TKCAJS/T89_2xESP32_front-rear_with_CanBUS/T89_Gearbox_Flowcharts.docx

Shift Up button pressed — ignition cut upshift

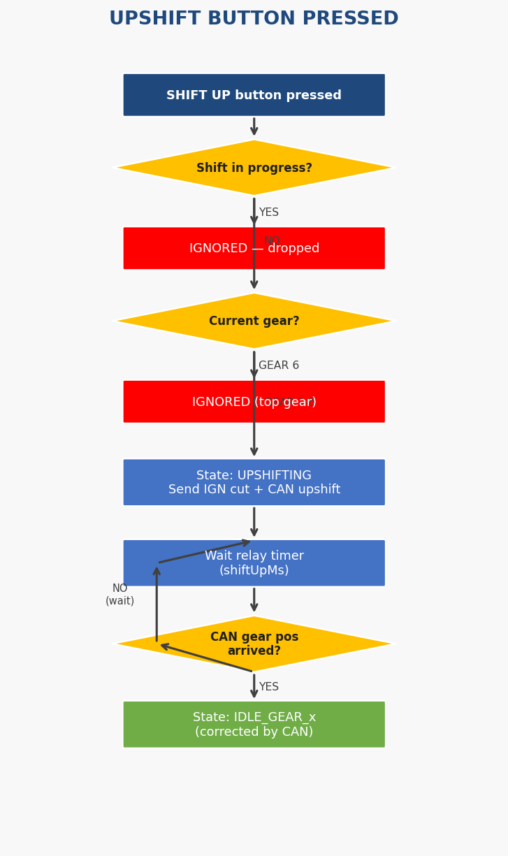
[picture p1: figure]

Shift Down button pressed — clutch servo downshift

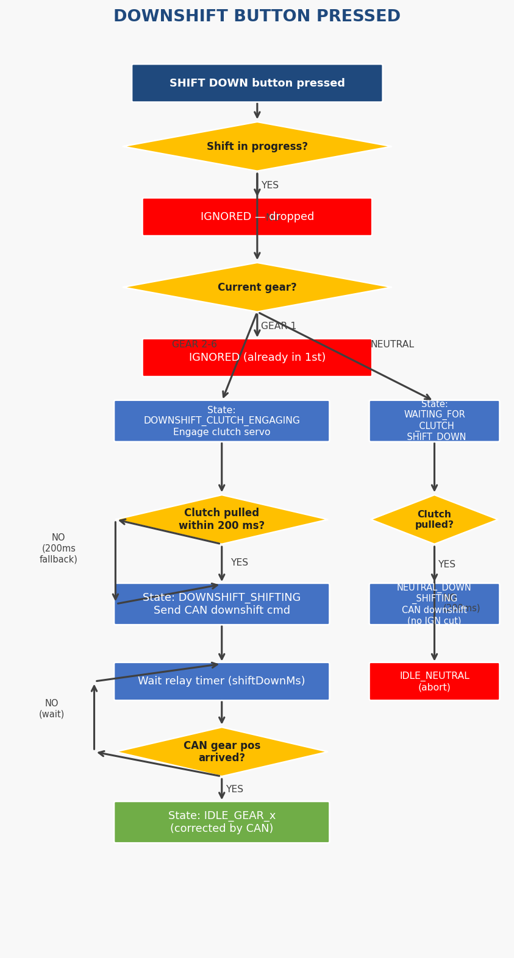
[picture p2: figure]

Neutral button pressed — single button, direction by gear

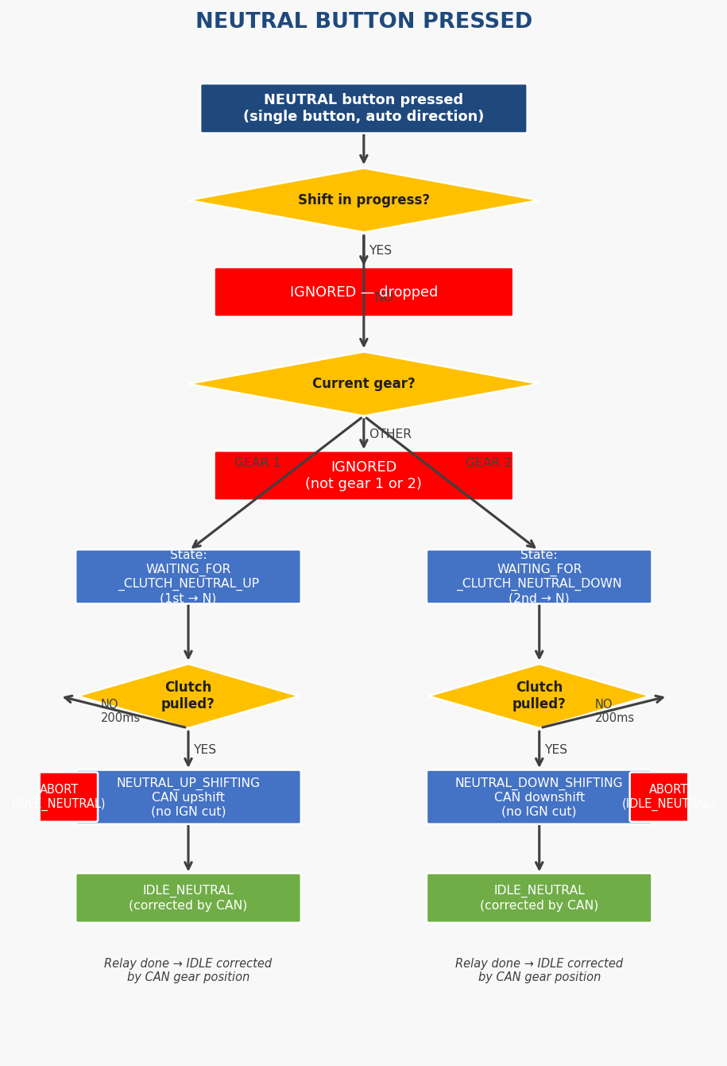
[picture p3: figure]

Manual mode — toggle and direct shift commands

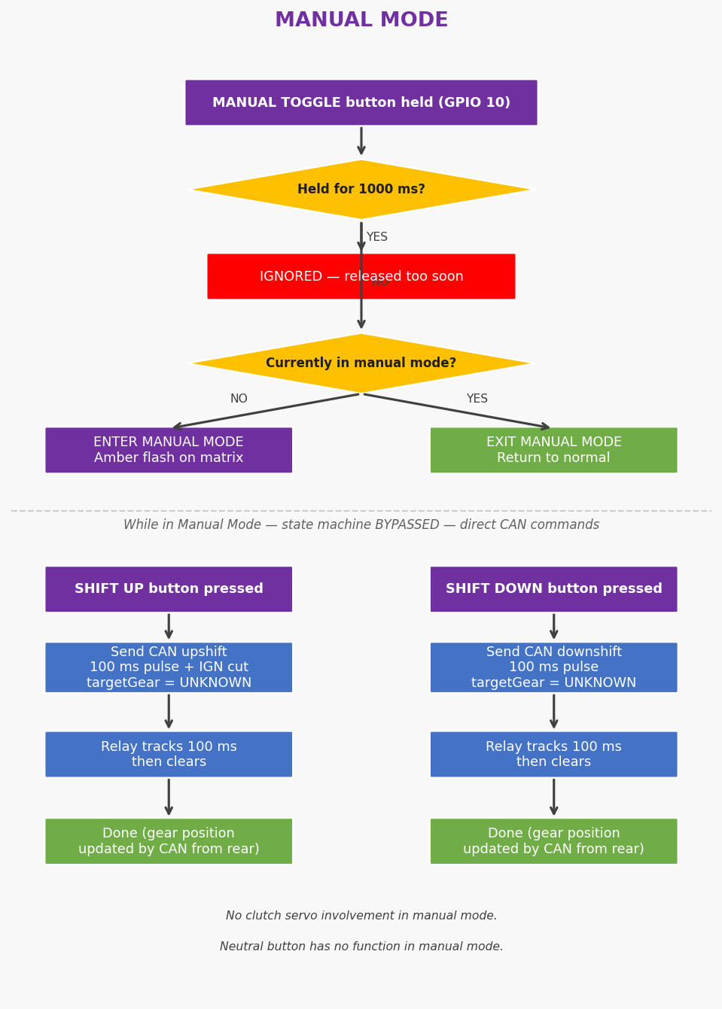
[picture p4: figure]
