TKCAJS/T89_2xESP32_front-rear_with_CanBUS/T89_Gearbox_State_Machine.docx

# T89 Gearbox State Machine — Quick Reference

CURRENT STATE | TRIGGER | NEXT STATE | ACTION | CLUTCH?
IDLE_NEUTRAL | Shift Down button | WAITING_FOR_CLUTCH_SHIFT_DOWN | Display C - wait for clutch pull | YES
IDLE_NEUTRAL | Shift Up button | WAITING_FOR_CLUTCH_SHIFT_UP | Display C - wait for clutch pull | YES
IDLE_GEAR_1 | Neutral Up button | WAITING_FOR_CLUTCH_NEUTRAL_UP | Display C - wait for clutch pull | YES
IDLE_GEAR_1 | Shift Up button | UPSHIFTING | IGN cut pulse + CAN upshift cmd | NO
IDLE_GEAR_2 | Neutral Down button | WAITING_FOR_CLUTCH_NEUTRAL_DOWN | Display C - wait for clutch pull | YES
IDLE_GEAR_2 | Shift Down button | DOWNSHIFT_CLUTCH_ENGAGING | Engage clutch servo, display D | YES
IDLE_GEAR_2 | Shift Up button | UPSHIFTING | IGN cut pulse + CAN upshift cmd | NO
IDLE_GEAR_3 / 4 / 5 / 6 | Shift Down button | DOWNSHIFT_CLUTCH_ENGAGING | Engage clutch servo, display D | YES
IDLE_GEAR_3 / 4 / 5 | Shift Up button | UPSHIFTING | IGN cut pulse + CAN upshift cmd | NO
WAITING_FOR_CLUTCH_NEUTRAL_DOWN | Clutch pulled | NEUTRAL_DOWN_SHIFTING | CAN downshift cmd (no IGN cut) | -
WAITING_FOR_CLUTCH_NEUTRAL_DOWN | Timeout (200 ms) | IDLE_NEUTRAL | Abort - no relay fired | -
WAITING_FOR_CLUTCH_NEUTRAL_UP | Clutch pulled | NEUTRAL_UP_SHIFTING | CAN upshift cmd (no IGN cut) | -
WAITING_FOR_CLUTCH_NEUTRAL_UP | Timeout (200 ms) | IDLE_NEUTRAL | Abort - no relay fired | -
WAITING_FOR_CLUTCH_SHIFT_DOWN | Clutch pulled | NEUTRAL_DOWN_SHIFTING | CAN downshift cmd (no IGN cut) | -
WAITING_FOR_CLUTCH_SHIFT_DOWN | Timeout (200 ms) | IDLE_NEUTRAL | Abort - no relay fired | -
WAITING_FOR_CLUTCH_SHIFT_UP | Clutch pulled | NEUTRAL_UP_SHIFTING | CAN upshift cmd (no IGN cut) | -
WAITING_FOR_CLUTCH_SHIFT_UP | Timeout (200 ms) | IDLE_NEUTRAL | Abort - no relay fired | -
DOWNSHIFT_CLUTCH_ENGAGING | Clutch pulled | DOWNSHIFT_SHIFTING | CAN downshift cmd immediately | -
DOWNSHIFT_CLUTCH_ENGAGING | Timeout (200 ms) - no clutch detected | DOWNSHIFT_SHIFTING | CAN downshift anyway (bench fallback) | -
DOWNSHIFT_SHIFTING | Relay timer done | IDLE_NEUTRAL (corrected by CAN) | Release clutch servo | -
NEUTRAL_DOWN_SHIFTING NEUTRAL_UP_SHIFTING UPSHIFTING | Relay timer done | IDLE_NEUTRAL (corrected by CAN) | Release clutch servo | -
ERROR_SHIFT_TIMEOUT | Immediate (next loop tick) | IDLE_NEUTRAL | Deactivate relay, release clutch | -

TIMEOUTS: Clutch wait = 200 ms | Shift relay timeout = 500 ms | Error recovery = immediate (next loop tick)

NOTES: New commands only accepted in IDLE states. No queuing - button presses during a shift are dropped. Gear state corrects automatically when CAN gear position arrives from rear node. Downshift 200 ms fallback fires relay even without clutch detection (bench testing / slow pull).
