TKCAJS/T89_2xESP32_front-rear_with_CanBUS/src/rear_node/RearDisplay.h

/**
 * RearDisplay.h
 * Diagnostic TFT display for the rear node (ST7789 170x320, Adafruit_ST7789)
 *
 * Shows:
 *   - Current gear (large, centre)
 *   - CAN bus status
 *   - Last shift command received (UP / DOWN) with timestamp
 *   - Node status flags
 */

#pragma once
#include <Arduino.h>
#include <SPI.h>
#include <Adafruit_GFX.h>
#include <Adafruit_ST7789.h>
#include <Fonts/FreeSans12pt7b.h>
#include <Fonts/FreeSans24pt7b.h>
#include "can_ids.h"



#define DISP_SCLK       14  //scl
#define DISP_MOSI       13  //sda
#define DISP_RST        12  //res
#define DISP_DC         11
#define DISP_CS         10
#define DISP_BL_PIN     9   //blk

// Colour definitions (RGB565)
#define COL_BLACK       0x0000
#define COL_WHITE       0xFFFF
#define COL_DARKGREY    0x4208
#define COL_LIGHTGREY   0x7BEF
#define COL_GREEN       0x07E0
#define COL_ORANGE      0xFD20
#define COL_RED         0xF800

enum ShiftDirection {
    SHIFT_NONE,
    SHIFT_UP,
    SHIFT_DOWN
};

enum CanHealth {
    CAN_HEALTH_OK,       // running, ACKs received
    CAN_HEALTH_NO_BUS,   // transceiver present but no other nodes on bus
    CAN_HEALTH_NO_XCVR,  // no transceiver connected (physical layer errors)
    CAN_HEALTH_BUS_OFF,  // bus-off / recovering
    CAN_HEALTH_FAULT     // driver not running
};

class RearDisplay {
public:
    RearDisplay() :
        _tft(DISP_CS, DISP_DC, DISP_RST),
        _gear(GEAR_UNKNOWN), _targetGear(GEAR_UNKNOWN), _canHealth(CAN_HEALTH_FAULT),
        _lastShift(SHIFT_NONE), _shiftAge(0),
        _nodeStatus(NODE_STATUS_OK), _needsFullRedraw(true),
        _gearDirty(true), _canDirty(true),
        _shiftDirty(true), _statusDirty(true) {}

    // -------------------------------------------------------------------------
    void begin() {
        pinMode(DISP_BL_PIN, OUTPUT);
        digitalWrite(DISP_BL_PIN, HIGH);

        SPI.begin(DISP_SCLK, -1, DISP_MOSI, DISP_CS);

        _tft.init(170, 320);
        _tft.setRotation(2);
        _tft.fillScreen(COL_BLACK);

        drawStaticLayout();
        _needsFullRedraw = false;

        Serial.println("[DISP] initialised");
    }

    // -------------------------------------------------------------------------
    void setGear(uint8_t gear) {
        if (gear != _gear) {
            _gear = gear;
            _gearDirty = true;
            // Clear target + shift indicator once the actual gear settles. A completed
            // shift makes the UP/DOWN box stale, so drop it now instead of waiting out
            // the 3s timeout — regardless of which direction was shown.
            if (gear != GEAR_BETWEEN && gear != GEAR_UNKNOWN) {
                _targetGear = GEAR_UNKNOWN;
                if (_lastShift != SHIFT_NONE) {
                    _lastShift  = SHIFT_NONE;
                    _shiftDirty = true;
                }
            }
        }
    }

    void setTargetGear(uint8_t gear) {
        if (gear != _targetGear) { _targetGear = gear; _gearDirty = true; }
    }

    void setCanHealth(CanHealth health) {
        if (health != _canHealth) { _canHealth = health; _canDirty = true; }
    }

    void setLastShift(ShiftDirection dir) {
        _lastShift  = dir;
        _shiftAge   = millis();
        _shiftDirty = true;
    }

    void setNodeStatus(uint8_t status) {
        if (status != _nodeStatus) { _nodeStatus = status; _statusDirty = true; }
    }

    // -------------------------------------------------------------------------
    void update() {
        if (_needsFullRedraw) {
            _tft.fillScreen(COL_BLACK);
            drawStaticLayout();
            _needsFullRedraw = false;
            _gearDirty = _canDirty = _shiftDirty = _statusDirty = true;
        }

        if (_gearDirty)   { drawGear();   _gearDirty   = false; }
        if (_canDirty)    { drawCan();    _canDirty    = false; }
        if (_shiftDirty)  { drawShift();  _shiftDirty  = false; }
        if (_statusDirty) { drawStatus(); _statusDirty = false; }

        // Clear shift indicator after 3 seconds
        if (_lastShift != SHIFT_NONE && (millis() - _shiftAge > 3000)) {
            _lastShift  = SHIFT_NONE;
            _shiftDirty = true;
        }
    }

    void forceRedraw() { _needsFullRedraw = true; }

private:
    Adafruit_ST7789 _tft;

    uint8_t        _gear;
    uint8_t        _targetGear;
    CanHealth      _canHealth;
    ShiftDirection _lastShift;
    uint32_t       _shiftAge;
    uint8_t        _nodeStatus;

    bool _needsFullRedraw;
    bool _gearDirty;
    bool _canDirty;
    bool _shiftDirty;
    bool _statusDirty;

    // -------------------------------------------------------------------------
    // Layout constants (170 wide, 320 tall, portrait)
    //
    //  ┌─────────────────┐  y=0
    //  │   REAR NODE     │  title bar     h=30
    //  ├─────────────────┤  y=30
    //  │                 │
    //  │      GEAR       │  large gear    h=140
    //  │                 │
    //  ├─────────────────┤  y=170
    //  │  CAN: XCVR OK   │  CAN status    h=60
    //  │       BUS OK    │
    //  ├─────────────────┤  y=230
    //  │  LAST: UP ^     │  shift event   h=40
    //  ├─────────────────┤  y=270
    //  │  STATUS: OK     │  node status   h=50
    //  └─────────────────┘  y=320

    static const int W        = 170;
    static const int Y_TITLE  = 0;
    static const int Y_GEAR   = 30;
    static const int Y_CAN    = 170;
    static const int Y_SHIFT  = 230;
    static const int Y_STATUS = 270;

    // -------------------------------------------------------------------------
    void drawTextCentred(const char *str, int cx, int y, uint8_t size, uint16_t colour) {
        _tft.setTextSize(size);
        _tft.setTextColor(colour, COL_BLACK);
        int16_t tw = strlen(str) * 6 * size;
        _tft.setCursor(cx - tw / 2, y);
        _tft.print(str);
    }

    void drawTextLeft(const char *str, int x, int y, uint8_t size, uint16_t colour) {
        _tft.setTextSize(size);
        _tft.setTextColor(colour, COL_BLACK);
        _tft.setCursor(x, y);
        _tft.print(str);
    }

    // GFX font helper — cx/topY are pixel centre-x and top-of-bounding-box.
    // Resets to default font after drawing.
    void drawGFXCentred(const char *str, int cx, int topY, const GFXfont *font, uint16_t colour) {
        _tft.setFont(font);
        _tft.setTextColor(colour, COL_BLACK);
        int16_t x1, y1;
        uint16_t w, h;
        _tft.getTextBounds(str, 0, 0, &x1, &y1, &w, &h);
        _tft.setCursor(cx - (int16_t)w / 2 - x1, topY - y1);
        _tft.print(str);
        _tft.setFont(NULL);
        _tft.setTextSize(1);
    }

    // -------------------------------------------------------------------------
    void drawStaticLayout() {
        _tft.fillRect(0, Y_TITLE, W, 30, COL_DARKGREY);
        drawTextCentred("REAR NODE", W / 2, Y_TITLE + 9, 2, COL_WHITE);

        drawTextLeft("GEAR",   4, Y_GEAR   + 2, 1, COL_LIGHTGREY);
        drawTextLeft("CAN",    4, Y_CAN    + 2, 1, COL_LIGHTGREY);
        drawTextLeft("SHIFT",  4, Y_SHIFT  + 2, 1, COL_LIGHTGREY);
        drawTextLeft("STATUS", 4, Y_STATUS + 2, 1, COL_LIGHTGREY);

        _tft.drawFastHLine(0, Y_CAN,    W, COL_LIGHTGREY);
        _tft.drawFastHLine(0, Y_SHIFT,  W, COL_LIGHTGREY);
        _tft.drawFastHLine(0, Y_STATUS, W, COL_LIGHTGREY);
    }

    // -------------------------------------------------------------------------
    void drawGear() {
        _tft.fillRect(0, Y_GEAR + 16, W, 140 - 16, COL_BLACK);

        // Vertically centre the big glyph in the usable 124px slot (y=46..170)
        static const int GEAR_AREA_MID = Y_GEAR + 16 + (140 - 16) / 2;  // y=108

        if (_gear == GEAR_UNKNOWN) {
            drawGFXCentred("?", W / 2, GEAR_AREA_MID - 20, &FreeSans24pt7b, COL_RED);
            drawTextCentred("NO SIGNAL", W / 2, Y_GEAR + 118, 1, COL_RED);
        } else if (_targetGear == GEAR_NEUTRAL || (_targetGear >= GEAR_1 && _targetGear <= GEAR_6)) {
            // Shift in progress — show target gear in orange until actual gear confirms
            if (_targetGear == GEAR_NEUTRAL) {
                drawGFXCentred("N", W / 2, GEAR_AREA_MID - 20, &FreeSans24pt7b, COL_ORANGE);
            } else {
                char buf[2];
                snprintf(buf, sizeof(buf), "%d", _targetGear);
                drawGFXCentred(buf, W / 2, GEAR_AREA_MID - 20, &FreeSans24pt7b, COL_ORANGE);
            }
            drawTextCentred("SHIFTING", W / 2, Y_GEAR + 118, 1, COL_ORANGE);
        } else if (_gear == GEAR_BETWEEN) {
            drawGFXCentred("---", W / 2, GEAR_AREA_MID - 20, &FreeSans24pt7b, COL_ORANGE);
            drawTextCentred("SHIFTING", W / 2, Y_GEAR + 118, 1, COL_ORANGE);
        } else if (_gear == GEAR_NEUTRAL) {
            drawGFXCentred("N", W / 2, GEAR_AREA_MID - 20, &FreeSans24pt7b, COL_GREEN);
        } else {
            char buf[2];
            snprintf(buf, sizeof(buf), "%d", _gear);
            drawGFXCentred(buf, W / 2, GEAR_AREA_MID - 20, &FreeSans24pt7b, COL_WHITE);
        }
    }

    // -------------------------------------------------------------------------
    void drawCan() {
        _tft.fillRect(0, Y_CAN + 16, W, 44, COL_BLACK);

        // Line 1: transceiver presence  (top of text at y+18)
        bool xcvrOk = (_canHealth != CAN_HEALTH_NO_XCVR && _canHealth != CAN_HEALTH_FAULT);
        if (xcvrOk) {
            drawGFXCentred("XCVR OK", W / 2, Y_CAN + 18, &FreeSans12pt7b, COL_GREEN);
        } else {
            drawGFXCentred("NO XCVR", W / 2, Y_CAN + 18, &FreeSans12pt7b, COL_RED);
        }

        // Line 2: bus status  (top of text at y+38)
        switch (_canHealth) {
            case CAN_HEALTH_OK:
                drawGFXCentred("BUS OK",  W / 2, Y_CAN + 38, &FreeSans12pt7b, COL_GREEN);
                break;
            case CAN_HEALTH_NO_BUS:
                drawGFXCentred("NO BUS",  W / 2, Y_CAN + 38, &FreeSans12pt7b, COL_ORANGE);
                break;
            case CAN_HEALTH_BUS_OFF:
                drawGFXCentred("BUS OFF", W / 2, Y_CAN + 38, &FreeSans12pt7b, COL_RED);
                break;
            case CAN_HEALTH_NO_XCVR:
            case CAN_HEALTH_FAULT:
            default:
                drawGFXCentred("------",  W / 2, Y_CAN + 38, &FreeSans12pt7b, COL_DARKGREY);
                break;
        }
    }

    // -------------------------------------------------------------------------
    void drawShift() {
        _tft.fillRect(0, Y_SHIFT + 16, W, 24, COL_BLACK);
        switch (_lastShift) {
            case SHIFT_UP:
                drawGFXCentred("UP  ^",  W / 2, Y_SHIFT + 18, &FreeSans12pt7b, COL_GREEN);
                break;
            case SHIFT_DOWN:
                drawGFXCentred("DOWN v", W / 2, Y_SHIFT + 18, &FreeSans12pt7b, COL_ORANGE);
                break;
            default:
                drawGFXCentred("---",    W / 2, Y_SHIFT + 18, &FreeSans12pt7b, COL_LIGHTGREY);
                break;
        }
    }

    // -------------------------------------------------------------------------
    // Draw one status flag row; skips rows that would fall off the panel.
    void drawStatusFlag(const char *txt, int &y) {
        if (y > 320 - 8) return;   // 8px glyph height at size 1
        drawTextLeft(txt, 4, y, 1, COL_RED);
        y += 10;
    }

    void drawStatus() {
        _tft.fillRect(0, Y_STATUS + 16, W, 320 - (Y_STATUS + 16), COL_BLACK);
        if (_nodeStatus == NODE_STATUS_OK) {
            drawGFXCentred("OK", W / 2, Y_STATUS + 18, &FreeSans12pt7b, COL_GREEN);
            return;
        }
        int y = Y_STATUS + 18;
        if (_nodeStatus & NODE_STATUS_SENSOR_ERR)   drawStatusFlag("SENSOR ERR",   y);
        if (_nodeStatus & NODE_STATUS_CAN_ERR)      drawStatusFlag("CAN ERR",      y);
        if (_nodeStatus & NODE_STATUS_ACTUATOR_ERR) drawStatusFlag("ACTUATOR ERR", y);
        if (_nodeStatus & NODE_STATUS_OVERTEMP)     drawStatusFlag("OVERTEMP",     y);
        if (_nodeStatus & NODE_STATUS_WATCHDOG)     drawStatusFlag("WATCHDOG RST", y);
        if (_nodeStatus & NODE_STATUS_CONFIG_ERR)   drawStatusFlag("CONFIG ERR",   y);
    }
};
