TKCAJS/T89_2xESP32_front-rear_with_CanBUS/src/main_node/GearFont.h

#ifndef GEAR_FONT_H
#define GEAR_FONT_H

#include <Arduino.h>

// Custom 2px-stroke bitmap font for the 16-row gear/status matrix.
//
// Digits are drawn as 7-segment shapes (no diagonals at all, so they stay
// crisp regardless of matrix resolution). Letters use straight bars where
// possible; N's diagonal is stepped once every ~3-4 rows instead of every
// row so it reads as a smooth diagonal rather than a staircase, and W
// (only ever shown for a brief WiFi-on flash) is the one glyph built from
// several shallow diagonals and is the roughest of the set.
//
// Each row is a bitmask, MSB-aligned to the glyph's width: bit (width-1-x)
// is pixel (x, row). Glyphs are 16 rows tall to match MATRIX_HEIGHT.

#define GEAR_FONT_HEIGHT 16

struct GearGlyph {
    char c;
    uint8_t width;
    const uint16_t* rows;
};

static const uint16_t GLYPH_ROWS_1[GEAR_FONT_HEIGHT] = { 0x000, 0x070, 0x0F0, 0x0F0, 0x070, 0x070, 0x070, 0x070, 0x070, 0x070, 0x070, 0x070, 0x070, 0x0F8, 0x0F8, 0x000 };
static const uint16_t GLYPH_ROWS_2[GEAR_FONT_HEIGHT] = { 0x000, 0x1F0, 0x3F8, 0x31C, 0x00C, 0x00C, 0x00C, 0x01C, 0x038, 0x070, 0x0E0, 0x1C0, 0x380, 0x3FC, 0x3FC, 0x000 };
static const uint16_t GLYPH_ROWS_3[GEAR_FONT_HEIGHT] = { 0x000, 0x3F0, 0x3F8, 0x01C, 0x00C, 0x00C, 0x01C, 0x0F8, 0x0F8, 0x01C, 0x00C, 0x00C, 0x01C, 0x3F8, 0x3F0, 0x000 };
static const uint16_t GLYPH_ROWS_4[GEAR_FONT_HEIGHT] = { 0x000, 0x018, 0x038, 0x070, 0x0E0, 0x1C0, 0x398, 0x718, 0x618, 0x7FE, 0x7FE, 0x018, 0x018, 0x018, 0x018, 0x000 };
static const uint16_t GLYPH_ROWS_5[GEAR_FONT_HEIGHT] = { 0x000, 0x7FE, 0x7FE, 0x600, 0x600, 0x600, 0x7F8, 0x7FC, 0x00E, 0x006, 0x006, 0x006, 0x00E, 0x7FC, 0x7F8, 0x000 };
static const uint16_t GLYPH_ROWS_6[GEAR_FONT_HEIGHT] = { 0x000, 0x1FC, 0x3FC, 0x700, 0x600, 0x600, 0x600, 0x7F8, 0x7FC, 0x60E, 0x606, 0x606, 0x70E, 0x3FC, 0x1F8, 0x000 };
static const uint16_t GLYPH_ROWS_N[GEAR_FONT_HEIGHT] = { 0x000, 0x606, 0x706, 0x786, 0x786, 0x6C6, 0x6C6, 0x666, 0x666, 0x636, 0x636, 0x61E, 0x61E, 0x60E, 0x606, 0x000 };
static const uint16_t GLYPH_ROWS_W[GEAR_FONT_HEIGHT] = { 0x000, 0x1B76, 0x1A26, 0x1B26, 0x1A26, 0x1A76, 0x1806, 0x1806, 0x18C6, 0x18C6, 0x19E6, 0x1BF6, 0x1F3E, 0x1E1E, 0x1C0E, 0x000 };
static const uint16_t GLYPH_ROWS_D[GEAR_FONT_HEIGHT] = { 0x000, 0x3F0, 0x3F8, 0x31C, 0x30C, 0x30C, 0x30C, 0x30C, 0x30C, 0x30C, 0x30C, 0x30C, 0x31C, 0x3F8, 0x3F0, 0x000 };
static const uint16_t GLYPH_ROWS_U[GEAR_FONT_HEIGHT] = { 0x000, 0x30C, 0x30C, 0x30C, 0x30C, 0x30C, 0x30C, 0x30C, 0x30C, 0x30C, 0x30C, 0x30C, 0x39C, 0x1F8, 0x0F0, 0x000 };
static const uint16_t GLYPH_ROWS_C[GEAR_FONT_HEIGHT] = { 0x000, 0x0F8, 0x1F8, 0x380, 0x300, 0x300, 0x300, 0x300, 0x300, 0x300, 0x300, 0x300, 0x380, 0x1F8, 0x0F8, 0x000 };
static const uint16_t GLYPH_ROWS_F[GEAR_FONT_HEIGHT] = { 0x000, 0x3FC, 0x3FC, 0x300, 0x300, 0x300, 0x300, 0x3E0, 0x3E0, 0x300, 0x300, 0x300, 0x300, 0x300, 0x300, 0x000 };
static const uint16_t GLYPH_ROWS_Q[GEAR_FONT_HEIGHT] = { 0x000, 0x3F8, 0x7FC, 0x60C, 0x00C, 0x00C, 0x00C, 0x07C, 0x0F8, 0x0C0, 0x0C0, 0x0C0, 0x000, 0x0C0, 0x0C0, 0x000 };

static const GearGlyph GEAR_FONT_GLYPHS[] = {
    { '1', 12, GLYPH_ROWS_1 },
    { '2', 12, GLYPH_ROWS_2 },
    { '3', 12, GLYPH_ROWS_3 },
    { '4', 12, GLYPH_ROWS_4 },
    { '5', 12, GLYPH_ROWS_5 },
    { '6', 12, GLYPH_ROWS_6 },
    { 'N', 12, GLYPH_ROWS_N },
    { 'W', 14, GLYPH_ROWS_W },
    { 'D', 12, GLYPH_ROWS_D },
    { 'U', 12, GLYPH_ROWS_U },
    { 'C', 12, GLYPH_ROWS_C },
    { 'F', 12, GLYPH_ROWS_F },
    { '?', 12, GLYPH_ROWS_Q },
};

static const GearGlyph* gearFontFind(char c) {
    for (const auto& g : GEAR_FONT_GLYPHS) {
        if (g.c == c) return &g;
    }
    return nullptr;
}

#endif
