TKCAJS/T89_2xESP32_front-rear_with_CanBUS/src/main_node/RPM.h

#ifndef RPM_H
#define RPM_H

#include <Arduino.h>
#include "driver/pcnt.h"

class RPM {
private:
    int rpmPin;
    float pulsesPerRevolution;
    float smoothingAlpha;  // 0.0 = no smoothing, 1.0 = max smoothing
    float currentRpm;

    unsigned long lastCalcTime;
    unsigned long lastPulseTime;
    int16_t       lastSeenCount = 0;            // last peeked PCNT value (liveness)
    const unsigned long calcInterval = 100;     // ms
    const unsigned long pulseTimeout = 2000;    // ms

    pcnt_unit_t pcntUnit = PCNT_UNIT_0;

public:
    RPM(int pin, float pulsesPerRev = 12.0, float smoothing = 0.2)
        : rpmPin(pin),
          pulsesPerRevolution(pulsesPerRev),
          smoothingAlpha(smoothing),
          currentRpm(0),
          lastCalcTime(0),
          lastPulseTime(0)
    {}

    void begin() {
        pinMode(rpmPin, INPUT);

        pcnt_config_t pcntConfig;
        pcntConfig.pulse_gpio_num = (gpio_num_t)rpmPin;
        pcntConfig.ctrl_gpio_num = PCNT_PIN_NOT_USED;
        pcntConfig.unit = pcntUnit;
        pcntConfig.channel = PCNT_CHANNEL_0;
        pcntConfig.pos_mode = PCNT_COUNT_INC;
        pcntConfig.neg_mode = PCNT_COUNT_DIS;
        pcntConfig.lctrl_mode = PCNT_MODE_KEEP;
        pcntConfig.hctrl_mode = PCNT_MODE_KEEP;
        pcntConfig.counter_h_lim = 10000;
        pcntConfig.counter_l_lim = 0;

        pcnt_unit_config(&pcntConfig);
        pcnt_set_filter_value(pcntUnit, 800);   // ~10 µs at 80 MHz APB — stays well below min tooth period at redline
        pcnt_filter_enable(pcntUnit);

        pcnt_counter_pause(pcntUnit);
        pcnt_counter_clear(pcntUnit);
        pcnt_counter_resume(pcntUnit);

        lastCalcTime = millis();
        lastPulseTime = millis();

        Serial.println("RPM sensor (PCNT) initialized");
        Serial.println("RPM Pin: " + String(rpmPin));
        Serial.println("RPM Pulses/Rev: " + String(pulsesPerRevolution, 1));
    }

    void update() {
        unsigned long now = millis();

        // Liveness, checked every call: peek the hardware counter (a cheap,
        // non-blocking register read). If it has advanced since last look, the
        // engine is turning — refresh the timeout. This is independent of the
        // calc interval and immune to loop stalls (WiFi / handleClient / etc.),
        // so a busy loop can never starve the RPM into a false zero.
        int16_t count = 0;
        pcnt_get_counter_value(pcntUnit, &count);
        if (count != lastSeenCount) {
            lastPulseTime = now;
            lastSeenCount = count;
        }

        if (now - lastCalcTime >= calcInterval) {
            calculateRpm(now - lastCalcTime);   // reads and clears the counter
            lastSeenCount = 0;                  // counter was just cleared
            lastCalcTime = now;
        }

        // Engine considered stopped only if the hardware counter has been
        // genuinely static for the whole timeout window.
        if (now - lastPulseTime > pulseTimeout) {
            currentRpm = 0;
        }
    }

    float getRpm() const {
        return currentRpm;
    }

    void setPulsesPerRevolution(float pulses) {
        pulsesPerRevolution = pulses;
    }

    float getPulsesPerRevolution() const {
        return pulsesPerRevolution;
    }

    void setSmoothing(float alpha) {
        smoothingAlpha = constrain(alpha, 0.0, 1.0);
    }

    float getSmoothing() const {
        return smoothingAlpha;
    }

private:
    void calculateRpm(unsigned long elapsedMs) {
        int16_t pulseCount = 0;
        pcnt_get_counter_value(pcntUnit, &pulseCount);
        pcnt_counter_clear(pcntUnit);

        if (pulseCount > 0) {
            lastPulseTime = millis();
        }

        float timeMinutes = elapsedMs / 60000.0f;
        float instantRpm = (pulseCount / timeMinutes) / pulsesPerRevolution;

        // Reject glitch samples — if RPM drops more than 40% in one window,
        // likely electrical interference from relay/servo. Skip the sample.
        if (currentRpm > 500 && instantRpm < currentRpm * 0.6f) {
            return;
        }

        // Exponential moving average (smoothing)
        currentRpm = (smoothingAlpha * instantRpm) + ((1.0 - smoothingAlpha) * currentRpm);

        // Clamp tiny noise values
        if (currentRpm < 10) currentRpm = 0;
    }
};

#endif // RPM_H
