TKCAJS/T89_2xESP32_front-rear_with_CanBUS/src/main_node/SerialCommands.h

#ifndef SERIAL_COMMANDS_H
#define SERIAL_COMMANDS_H

#include <Arduino.h>

// Forward declarations
class HallSensorControl;
class GearboxStateMachine;
class ShiftLogger;

class SerialCommands {
private:
    HallSensorControl* hallSensor;
    GearboxStateMachine* gearbox;
    ShiftLogger* shiftLogger;

public:
    SerialCommands() : hallSensor(nullptr), gearbox(nullptr), shiftLogger(nullptr) {}

    void begin(HallSensorControl* hall, GearboxStateMachine* stateMachine, ShiftLogger* logger) {
        hallSensor = hall;
        gearbox = stateMachine;
        shiftLogger = logger;

        Serial.println("Serial command interface ready");
        Serial.println("Type 'help' for available commands");
    }
    
    // Method declarations only - implementations will be in the main file
    void processCommands();
    void printHelp();
};

#endif

// end of code
