TKCAJS/T89_2xESP32_front-rear_with_CanBUS/src/main_node/SimpleServo.h

#pragma once
#include <Arduino.h>

// Minimal servo driver using ledcAttach/ledcWrite (arduino-esp32 3.x)
// Replaces ESP32Servo to avoid MCPWM crash on pioarduino/ESP-IDF 5.x
//
// 50Hz PWM, 14-bit resolution (ESP32-S3 max at 50Hz):
//   Period = 20ms, 1 tick = 20000us / 16384 = 1.2207us
//   500us  (0°)   = 410 ticks
//   2500us (180°) = 2048 ticks

#define SIMPLE_SERVO_FREQ       50
#define SIMPLE_SERVO_BITS       14
#define SIMPLE_SERVO_MIN_TICKS  410
#define SIMPLE_SERVO_MAX_TICKS  2048

class SimpleServo {
    int   _pin = -1;
    int   _minAngle = 0;
    int   _maxAngle = 180;
    float _lastAngle = 0;   // last commanded angle (any write path) — the real position

public:
    void attach(int pin) {
        _pin = pin;
        ledcAttach(pin, SIMPLE_SERVO_FREQ, SIMPLE_SERVO_BITS);
    }

    void setLimits(int minAngle, int maxAngle) {
        _minAngle = minAngle;
        _maxAngle = maxAngle;
    }

    void write(int angle) {
        if (_pin < 0) return;
        angle = constrain(angle, _minAngle, _maxAngle);
        _lastAngle = (float)angle;
        uint32_t ticks = map(angle, 0, 180, SIMPLE_SERVO_MIN_TICKS, SIMPLE_SERVO_MAX_TICKS);
        ledcWrite(_pin, ticks);
    }

    // Sub-degree positioning — maps a fractional angle straight to PWM ticks.
    // Resolution floor is the tick size (~0.11° at 14-bit / 50 Hz).
    void writeFloat(float angle) {
        if (_pin < 0) return;
        angle = constrain(angle, (float)_minAngle, (float)_maxAngle);
        _lastAngle = angle;
        uint32_t ticks = (uint32_t)(SIMPLE_SERVO_MIN_TICKS +
            (angle / 180.0f) * (SIMPLE_SERVO_MAX_TICKS - SIMPLE_SERVO_MIN_TICKS) + 0.5f);
        ledcWrite(_pin, ticks);
    }

    // Last commanded angle — the actual position the servo was told to go to.
    float getAngle() const { return _lastAngle; }

    void detach() {
        if (_pin < 0) return;
        ledcDetach(_pin);
        _pin = -1;
    }

    bool attached() { return _pin >= 0; }
};
