TKCAJS/T89_2xESP32_front-rear_with_CanBUS/(commit log)

2026-03-31 main node: removed relay triggers and replaced with CAN transmits. rear node: added heartbeat flash
    [GearboxStateMachine.cpp, GearboxStateMachine.h, MainCan.h, ManualMode.h, T89_gearbox_206.cpp, WebInterface.h, main.cpp]
2026-04-03 reassigned display & gear position gpio on rear node. gear position tested ok.
2026-04-03 canbus recovery added, remaining 8575 removed
2026-04-08 main node: single neutral switch with auto direction, long press manual mode toggle
2026-04-08 update pin mappings and added "target gear" to rear node
2026-04-09 can_ids.h: add CAN_MAIN_RPM and CAN_MAIN_SHIFT_STATUS message types
    Added two new outbound message types for NODE_MAIN:
    - MSGTYPE_MAIN_RPM (0x04) / CAN_MAIN_RPM: RPM broadcast at ~20ms interval.
    Payload: data[2:3] = RPM as uint16_t little-endian.
    - MSGTYPE_MAIN_SHIFT_STATUS (0x05) / CAN_MAIN_SHIFT_STATUS: shift mode
    broadcast at 1Hz. Payload: data[2] = 0 (Auto) or 1 (Manual).
    These IDs are required by the display node (NODE_DISPLAY) which is being
    migrated from serial telemetry to CAN. The main node firmware to transmit
    these frames is a separate task.
2026-04-10 Move WiFi switch from GPIO 9 to GPIO 21; document GPIO 9 as unusable
    GPIO 9 on ESP32-S3-DevKitC-1 is tied to the onboard BOOT button via
    pull-up resistor, causing a ~1.5V reading that can't be overridden in
    software. Moved WiFi toggle switch to GPIO 21.
2026-04-11 main node: broadcast RPM and shift mode on CAN
    Added to MainCan.h:
    - sendRpm(uint16_t rpm): transmits CAN_MAIN_RPM at ~20ms, data[2:3] = RPM uint16_t LE
    - sendShiftStatus(bool manual): transmits CAN_MAIN_SHIFT_STATUS at 1Hz, data[2] = 0 (Auto) / 1 (Manual)
    Both called from main loop in T89_gearbox_206.cpp with static-timer throttling.
    Also removed dead code: rpmISR() and g_rpmPulseCount were left over from the
    pre-PCNT interrupt-based RPM approach and were never called/read.
2026-04-11 updated RPM handling, added to canbus
2026-04-17 fix matrix tachometer RPM thresholds; remove redundant MatrixTachometer.h
    - Correct RPM thresholds in MatrixDisplay (were off by ~35% vs intended)
    - Delete unused MatrixTachometer.h (was never called)
    - Remove tachometer serial commands (tachotest/tachoinfo/rpminfo)
    - Fix LittleFS data_dir in platformio.ini
    [GearShift.h, MatrixDisplay.h, T89_gearbox_206.cpp]
2026-04-18 Add sensor node (STM32H562) CAN IDs and project documentation
    - NODE_SENSOR (0x0A): WeAct STM32H562RGT6 analog sensor hub
    - New CAN IDs: oil pressure, water temp, TPS, speed, fuel×2, pump status/command
    - CLAUDE.md: sensor node pinout (FDCAN1 PB7/PB8), occupied pins, can_ids.h sync rule
    - Speed sensor updated from "future" to received via CAN_SENS_SPEED
2026-04-19 neutral paddle: no clutch required; N shown on matrix; async startup anim
    - Neutral paddle (1st→N, 2nd→N) now shifts immediately without clutch wait
    - Matrix shows 'N' on neutral shift; red 'N' if gear unknown (test rig)
    - Notification colour parameterised on displayShiftNotification()
    - Startup animation runs in FreeRTOS task so setup() is non-blocking
2026-04-20 Clutch calibration: hall range, voltage thresholds, servo slider (2026-04-19 21:13)
    - HallSensorControl: hallMin/hallMax stored in Prefs, replace hardcoded 780/4000
    - T89_gearbox_206: clutchDisengageV + clutchJustEngagedV replace #define threshold
    - WebInterface: 6 new /cmd actions (setServoPos, saveClutchIdle, saveClutchEngage,
    saveHallRange, captureDisengageV, captureJustEngagedV); fix sensorData/configData
    - calibration.html: servo slider with live feedback, voltage bar with threshold
    markers, capture buttons for disengage and just-engaged thresholds
    - fix_mklittlefs.py + platformio.ini: workaround pioarduino MKFSTOOL PATH bug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
    [HallSensorControl.h, T89_gearbox_206.cpp, WebInterface.h, fix_mklittlefs.py]
2026-04-20 Calibration slider: servo override toggle to pause hall sensor (2026-04-20 11:36)
    - HallSensorControl: servoOverride flag; updateClutchControl backs off when set
    - WebInterface: enableServoOverride / disableServoOverride /cmd actions;
    expose servoOverride state in sensorData JSON; extern HallSensorControl
    - calibration.html: Enable/Disable Slider Mode toggle button; syncs state
    from live data; sendBeacon disables override on page unload
2026-04-20 fix calibration page: replace Unicode symbols with HTML entities
    Degree signs, arrows, bullet and em-dash were rendering as garbled
    characters (e.g. Â°) without a charset declaration. Replaced all
    with ASCII-safe HTML entities (&deg; &larr; &rarr; &bull; &mdash;).
2026-04-20 Piecewise clutch mapping: biting zone calibration, servo limits, streaming file serve (2026-04-20)
    - HallResponseTypes.h: add HALL_PIECEWISE curve type (3-zone map)
    - HallSensorControl.h: piecewise mapping, hallMin/hallMax defaults 780/3330, setCurveType supports piecewise, save/load piecewise breakpoints
    - SimpleServo.h: setLimits() to hard-clamp servo travel (42-137 deg)
    - T89_gearbox_206.cpp: CLUTCH_SERVO_MIN/MAX defines, hallMax default 3330, two voltage thresholds (disengage/just-engaged)
    - ManualMode.h: map calls use hallSensor->getHallMin/Max() instead of hardcoded values
    - WebInterface.h: setCurveType and savePiecewiseZone cmd actions, configData includes piecewise breakpoints and se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
2026-04-20 calibration.html: replace non-ASCII Unicode with HTML entities (2026-04-20)
    Degree signs use &deg;, em dashes use &mdash; in HTML/innerHTML context.
    JS textContent strings use \u00B0 escape or ASCII dash.
2026-04-20 Web UI: downshift trigger display, horizontal bar gauges, remove voltage inversion
    - index.html: add auto-downshift trigger section (live display, editable input,
    save to flash); remove hall curve config box; use 2-col grid
    - calibration.html: replace circular hall gauge with 3 horizontal bars
    (hall raw, servo degrees, clutch voltage)
    - WebInterface.h: add setJustEngagedV cmd; send clutchVoltage as raw (no inversion)
    - Remove 3.3-raw inversion throughout — raw ADC voltage used directly everywhere
    [WebInterface.h]
2026-04-21 calibration.html: don't overwrite piecewise inputs while user is editing
2026-04-21 calibration.html: fix hall range test timeout overwriting successful results
2026-04-26 GearboxStateMachine: fix shift refused after rapid sequential upshifts
    After relay fires, transition immediately to expectedGear idle state rather
    than IDLE_NEUTRAL. Eliminates the gap where the next shift press hits
    IDLE_NEUTRAL and enters WAITING_FOR_CLUTCH (showing 'C') before CAN gear
    confirmation arrives from the rear node. CAN confirmation still corrects
    state if the physical shift failed.
    Also remove legacy GearSensorControl.h (obsolete PCF8575 code, superseded
    by rear node CAN) and remove duplicate shiftLogger.onGearChanged() call in
    main loop (state machine already calls it in setCurrentGear()).
    [GearboxStateMachine.cpp, GearboxStateMachine.h, T89_gearbox_206.cpp]
2026-04-26 GearboxStateMachine: add stacked downshift feature
    Queues downshift paddle presses during an active downshift sequence.
    Each press decrements targetGear (floored at 1). After CAN confirms each
    gear change, fires the next downshift immediately if currentGear > targetGear.
    Clears on upshift press or when target is reached/shift fails.
    Broadcasts targetGear immediately on change via new CAN_MAIN_SHIFT_STACK
    message (MSGTYPE_MAIN_SHIFT_STACK 0x06, CAN_PRIO_HIGH).
    [GearboxStateMachine.cpp, GearboxStateMachine.h, MainCan.h, T89_gearbox_206.cpp]
2026-05-01 calibration.html: rename lever to paddle in Hall sensor section
2026-05-04 RPM: use actual elapsed time instead of fixed 100ms window
    Passes real millis delta to calculateRpm() so CPU load-induced jitter
    no longer causes RPM over-reads when the loop runs late.
    [RPM.h]
2026-05-10 stacked downshift, CAN recovery, RPM glitch protection, rear display flip
    - GearboxStateMachine: accept stacked downshift press in any non-idle state
    - MainCan: add bus-off detection and auto-recovery (check every 1s)
    - RPM: reject samples dropping >40% in one window (relay/servo interference)
    - RearDisplay: rotate 180° for inverted screen mounting
    [GearboxStateMachine.cpp, MainCan.h, RPM.h, RearDisplay.h]
2026-05-10 GearboxStateMachine: always clear stack on upshift
    Previously canSendShiftStack(0) was only sent if targetGear > 0,
    leaving display with stale stack values after upshifting post-sequence.
2026-05-20 MainCan: remove blocking delay and non-blocking shift TX
    - Remove delay(50) from CAN recovery path — was blocking main loop
    during rapid button presses, starving RPM updates
    - sendShiftUp/Down changed to timeout=0 (non-blocking); shift commands
    are fire-and-forget, stalling 5ms per press was unnecessary
    [MainCan.h]
2026-05-22 v210: dual hall sensor, version bump
    - HallSensorControl: add second hall paddle on GPIO 4 (HALL_PIN_2),
    higher value of both paddles wins
    - Bump SOFTWARE_VERSION to 210.0
2026-05-22 v211: hall pin 4 rescaling, dual paddle display on calibration page
    - HallSensorControl: remap pin 4 (1000-3600) onto pin 5 scale (770-3300)
    before max() so both paddles are comparable
    - WebInterface: expose hallLeft, hallRight (raw), hallValue (scaled result)
    - calibration.html: show Left Paddle, Right Paddle, Paddle (result)
2026-05-22 node versioning: heartbeat broadcasts version on CAN
    - MainCan: send CAN_HB_MAIN at 1Hz with MAIN_NODE_VERSION (211) in bytes 2-3
    - rear_node: define SOFTWARE_VERSION 100, pack into CAN_HB_REAR payload
    - T89_gearbox_206: bump to v212 to reflect versioning feature
2026-06-02 Add NVS config web UI and dual hall sensor calibration
    - CalConfig.h: versioned CRC-verified NVS blob for calibration scalars
    - WebInterface: GET/POST /api/config, POST /api/defaults REST endpoints
    - nvsconfig.html: simple pit-side calibration page (timing + servo angles)
    - Hall calibration: pin4 idle/pulled ranges now captured and saved per-paddle;
    pin4 raw mapped onto pin5 scale using calibrated ranges (not hardcoded constants)
    - index.html: simplified; links to /nvsconfig and /calibration
    - Removed old web pages from src root (moved to data/ folder previously)
    - platformio.ini: add ArduinoJson v7
2026-06-03 Refactor web UI: consistent nav, NVS as save authority
    - Add matching 3-button nav (Home/Calibration/NVS Config) to all three
    pages with current page muted; remove per-page ad-hoc nav styles
    - Remove duplicate gear/clutch config form from index.html and temp
    control card; index is now status/gauges/bite-point only
    - Remove NVS save buttons from calibration.html (saveHallCalibration,
    saveClutchIdle, saveClutchEngage, pendingHallRange); calibration page
    is now a live testing wizard only, with links to NVS Config for saving
    - Upgrade savePiecewiseZone with full bounds validation, per-field
    invalid highlighting, and read-back confirmation via /configData
    - Fix malformed anchor tag in n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
2026-06-06 sensor_node: scaffold PlatformIO project for WeAct STM32H562RGT6
    Adds boards/weact_h562rgt6.json custom board definition, sensor_node
    platformio.ini environment (ststm32, arduino framework), and initial
    main.cpp with GPIO blanket-analog init, ST7735 display, Dallas OneWire,
    analogue sensor placeholders, and pump PWM skeleton.
2026-06-06 sensor_node: fix board definition and GPIO_PIN_ALL case
    Renamed board weact_h562rgt6 -> weact_h562rg to match the variant
    header variant_WEACT_H562RG.h in the STM32duino core. Fixed variant
    path to STM32H5xx/H562R(G-I)T, added openocd_target/jlink_device,
    corrected flash size to 1MB (G density). Fixed GPIO_PIN_All -> GPIO_PIN_ALL.
    Build passes: 5.4% flash, 0.3% RAM.
    [main.cpp]
2026-06-06 sensor_node: confirm display pin assignments
    SPI2 on PB13(CLK)/PB15(DIN), CS=PB12, DC=PC6, RST=PC7.
    BL wired to 3.3V (always on, no GPIO). Switches to SPIClass
    instance constructor for explicit SPI2 use.
2026-06-06 sensor_node: switch upload to DFU
    Bundled OpenOCD (Jan 2023) has no stm32h5x.cfg — STM32H5 support was
    added later. DFU via USB works with the already-installed tool-dfuutil.
2026-06-06 sensor_node: fix display init — INITR_REDTAB confirmed working
    1.8" 128x160 ST7735 module requires INITR_REDTAB, not INITR_BLACKTAB.
    Also removed redundant SPI_2.begin() (Adafruit handles it internally).
    [main.cpp]
2026-06-06 sensor_node: lock display config — INITR_REDTAB, patchOffset(0,1), rotation 0
    Portrait 128×160, clean edges confirmed on hardware. Root causes found:
    - INITR_REDTAB==INITR_144GREENTAB (0x01) → setRotation set _width=128; fixed
    by overriding setRotation in ST7735Patched subclass.
    - Panel window starts at row 1, not 0 → patchOffset(0,1) corrects RASET.
    - Landscape (rot 1/3) always exposed 1-2px edge garbage on one side;
    portrait (rot 0) gives clean edges. Module to be rotated 90° on mount.
    [main.cpp]
2026-06-06 sensor_node: add SensorDisplay/SensorCan, wire FDCAN1 CAN bus
    - Extract display to SensorDisplay.h (procedural, no class) — displayBegin/displayUpdate with dirty detection, CAN health indicator in title bar
    - Add SensorCan.h — FDCAN1 on PB7(TX)/PB8(RX) at 500 Kbps via HAL; TX helpers for all MSGTYPE_SENS_* frames; handles CAN_SENS_CMD_PUMP duty override
    - Replace delay(50) loop with millis-based tasks: sensors 50ms, CAN TX 100ms, health 500ms, heartbeat/status 1Hz
    - Dallas reads made non-blocking (setWaitForConversion false)
    - Add SOFTWARE_VERSION 100, printed at boot
    - Add build_flags -DHAL_FDCAN_MODULE_ENABLED to sensor_node env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
    [SensorCan.h, SensorDisplay.h, main.cpp]
2026-06-07 added separate display elements for sensor node
2026-06-07 sensor_node: add RPM/gear display, fix FDCAN clock, fix gear update lag
    - canInit() was relying on the FDCANSEL reset default (HSE), which this
    board never enables, leaving FDCAN1 with no functional kernel clock.
    Explicitly route it from PLL1Q (50 MHz) and recalculate bit-timing for
    500 kbps at that clock.
    - Add RPM and gear position rows to the display (sourced over CAN from
    the main and rear nodes) to demonstrate two-way bus comms.
    - Drain the RX FIFO every loop iteration instead of every 500ms — RPM
    alone arrives at ~20ms cadence and was evicting the much rarer gear
    position frames from the 3-deep FIFO before they could be read.
    - Add protocol error/counter logging to canHea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
    [SensorCan.h, SensorDisplay.h, main.cpp]
2026-06-09 main_node: fix boot CAN dropout + gear flicker; sensor_node: drop CAN debug spam
    main_node (MainCan.h):
    - Gate periodic TX (RPM 50Hz, heartbeat, shift status) on a _busLive flag
    set only after receiving a frame. main was the only node flooding TX
    unconditionally at boot; with no ACKs yet it drove TEC to bus-off in
    ~640ms and then stopped receiving, so it never got rear's gear frames.
    Mirrors the TX-gating the rear and sensor nodes already do.
    - Decode RX on the full CAN identifier instead of the msgtype nibble.
    msgtypes collide across nodes (CAN_SENS_OIL_PRESSURE and
    CAN_REAR_GEAR_POS both use 0x01), so once the sensor node was reliably
    on the bus its oil-pressure frames were p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
    [MainCan.h, SensorCan.h]
2026-06-09 sensor_node: enable float printf so display renders %f rows
    The ststm32 build links --specs=nano.specs, which omits floating-point
    support from the printf/snprintf family (unlike the mxchip variant, the
    standard arduino build doesn't add -u _printf_float). snprintf("%.1f")
    produced empty output, so float display rows (OIL/TPS/FUEL/WATER/DALL)
    showed only their trailing unit — e.g. a bare "C" on the Dallas temp row
    — while the %u integer rows (RPM/gear/pump) rendered fine.
    Add -Wl,-u,_printf_float to pull float printf into the link. ~11 KB flash.
2026-06-09 sensor_node: publish Dallas radiator temp on CAN (CAN_SENS_RADIATOR_TEMP)
    Add MSGTYPE_SENS_RADIATOR_TEMP (0x09) / CAN_SENS_RADIATOR_TEMP, encoded
    int16 °C×10 like the other temps. The sensor node now transmits the
    DS18B20 reading (g_dallasTemp) in the 100ms TX block, so the radiator
    temp is available to the rest of the bus instead of being shown only on
    the local display.
2026-06-09 sensor_node: add temperature-scheduled cooling pump control
    New PumpControl.h (plain functions, no classes) maps radiator temp to
    pump duty: <50°C → 20%, 50-70°C → 30%, ≥70°C → 100%, with a disconnected
    DS18B20 (~-127°C) failing to 100% for max cooling. main.cpp recomputes
    g_pumpDuty from the Dallas reading once per second; the existing
    analogWrite applies it.
    Note: this now drives g_pumpDuty, superseding the CAN_SENS_CMD_PUMP
    override (which would be overwritten within 1s).
    [PumpControl.h, main.cpp]
2026-06-09 sensor_node: extract Dallas temperature into DallasTemp.h
    Move the DS18B20/OneWire sensor (objects, pin, period, cached value, and
    the non-blocking 1 Hz read) out of main.cpp into a self-contained
    DallasTemp.h with plain functions: dallasBegin(), dallasUpdate(now),
    dallasTempC(). main.cpp now just orchestrates — no OneWire/Dallas refs.
    Pure code-move, behaviour unchanged. Keeps the node modular ahead of a
    planned AnalogSensors.h split.
2026-06-09 sensor_node: set pump PWM to 25 kHz for 4-wire fan bench testing
    PUMP_PWM_FREQ_HZ constant + analogWriteFrequency() in setup. 25 kHz suits
    the PC fan used for bench tests (quiet); change back to 100 Hz for the
    real pump.
2026-06-09 main_node: show radiator temp on web index gauge; fix ° charset
    - MainCan decodes CAN_SENS_RADIATOR_TEMP (sensor node Dallas) into
    _radiatorTemp with getRadiatorTemp(); getRadiatorTempForWeb() helper
    feeds it into /sensorData as "currentTemp".
    - index.html's existing (but never-fed) tempGauge now renders it;
    relabelled "Radiator Temp", gauge max 120 -> 130 for DS18B20 headroom.
    - Add <meta charset='UTF-8'> to index.html and calibration.html — the °
    symbol (stored UTF-8 c2 b0) was rendering as Â° without it.
    [MainCan.h, T89_gearbox_206.cpp, WebInterface.h]
2026-06-09 main_node: pump% inner gauge ring + float clutch servo resolution
    Web temp gauge:
    - Decode CAN_SENS_PUMP_STATUS (sensor node pump duty) in MainCan;
    getPumpDutyForWeb() feeds /sensorData as "pumpDuty".
    - index.html drawTempPumpGauge() renders pump % as a concentric inner
    ring inside the radiator-temp gauge (outer orange = temp, inner cyan
    = pump), values stacked in the centre.
    Clutch servo resolution:
    - SimpleServo gains writeFloat() for sub-degree positioning (~0.11°/tick
    floor at 14-bit/50 Hz) and records the last commanded angle (getAngle).
    - HallSensorControl maps hall->servo in float (mapf) instead of the
    integer map() that quantised to whole degrees; updateClutchControl now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
2026-06-09 main_node web: raw clutch voltage + gauge relabels/reverse-arc
    - calibration.html: drop the 3.3 - v inversion in the disengage/just-engaged
    capture confirmations; show the raw saved voltage to match the live bar
    and firmware (which already store/return raw).
    - index.html: relabel gauges to match what they show — "Clutch Position"
    -> "Servo Reported Position" (feedback voltage), "Servo Position" ->
    "Servo Position Commanded" (actual commanded angle).
    - index.html: drawGauge gains optional decimals + reverseArc args. The
    reported-position gauge shows raw voltage to 2 dp with a reversed arc
    sweep so it tracks the same direction as the commanded gauge (feedback
    is electrically in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
2026-06-09 main_node: robust RPM liveness vs loop stalls + MAX9926 EMI notes
    RPM.h: drive the engine-running/timeout decision off the hardware PCNT
    counter advancing, peeked every loop via a non-blocking register read,
    instead of only refreshing inside the 100ms calc path. This decouples
    liveness from loop timing, so WiFi/handleClient stalls can no longer
    starve it into a momentary false zero. Pulse counting was already
    hardware/non-blocking; only the liveness logic was fragile.
    Add MAX9926_EMI_notes.md documenting hardware measures to harden the VR
    sensor front-end against WiFi-band EMI (input CM/diff filtering,
    hysteresis, adaptive threshold, twisted/shielded cabling, output-side
    ferrite/RC, layout)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
    [RPM.h]
2026-06-12 sensor_node: ST7789 240x320 display, IRQ-driven CAN RX, 5 Hz tasks
    - Swap ST7735 128x160 driver for ST7789 2.4" 240x320, portrait,
    setRotation(2) (flipped 180 to match mount). Rescale layout: 32px
    header + 9 rows x 32px, textSize 2. Drop ST7735Patched/INITR/offset
    workarounds (ST7789 init(240,320) needs none).
    - Move RX FIFO draining into the FDCAN1_IT0 new-message interrupt. The
    3-deep RX FIFO overran while the loop blocked on the SPI display write,
    dropping the rear node's on-change gear frame (gear then lagged up to
    the 1 Hz refresh). ISR drain decouples RX from loop timing. Mark
    ISR-shared globals volatile; strip Serial/RMW from the ISR path.
    - Run all periodic tasks at 200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
    [SensorCan.h, SensorDisplay.h, main.cpp]
2026-06-13 main_node v213: ADS1115 differential clutch position read
    Replace noisy GPIO15 single-ended analogRead of the servo position
    feedback with a 16-bit ADS1115 read in differential mode (A0-A1) over
    I2C (SDA8/SCL14, addr 0x48), with a 2:1 divider on the 0-5V feedback.
    Differential A1 references the servo's signal ground to reject ground
    bounce/EMI. Bench-verified ~0.003V jitter across a 1.46V travel span.
    Falls back to the legacy GPIO15 analogRead if the ADS1115 is not
    detected at boot, so the bike still runs without the chip.
    Also move the right clutch-paddle hall pin out of HallSensorControl.h
    (hardcoded #define) into the central pin map as PIN_HALL_SENSOR_2 and
    inject it via the constructor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
    [HallSensorControl.h, T89_gearbox_206.cpp, WebInterface.h]
2026-06-14 main_node: ADS1115 clutch divider 4.7k/6.8k (0.591), update CLUTCH_FB_DIVIDER
    Replace 2:1 (10k/10k) servo-feedback divider with 4.7k top / 6.8k bottom
    (ratio 0.591), keeping 5V max at ~2.96V under the 3.3V ADS1115 VDD ceiling
    at GAIN_ONE. CLUTCH_FB_DIVIDER 2.0 -> 1.691 so clutchVoltage stays in true
    servo volts and existing bite-point thresholds remain valid. 0.1uF across
    A0-A1 for EMI.
    [T89_gearbox_206.cpp]
2026-06-16 hall: add idle deadband to suppress servo jitter; bump PCNT filter to hw max
    - capturePin1/2Idle() adds HALL_IDLE_DEADBAND (30 ADC counts) to the captured
    idle reading so sensor noise at rest can't push hallValue above hallMin and
    twitch the servo; paddle must be pulled past the deadband before servo moves
    - PCNT filter raised from 100 to 1023 cycles (~12.8 µs at 80 MHz APB, max HW
    value), well below the ~385 µs min tooth period at redline — kills residual
    edge noise that would inflate the count
    [HallSensorControl.h, RPM.h]
2026-06-16 main_node: rename clutchEngagePos -> clutchFullyPull throughout
    Old name read backwards vs the servo's action. clutchFullyPull = servo has
    pulled the clutch lever fully = drive disconnected = safe-to-shift end;
    clutchIdlePos = resting/driving end. Renamed C++ identifiers, CalConfig
    struct field + JSON keys, the gearbox-namespace NVS key string (15 chars,
    at the ESP32 limit), web form args, and HTML ids across firmware + data
    pages. CalConfig CRC blob layout unchanged (rename is offset-stable).
2026-06-16 main_node: smoothstep corner blend for piecewise clutch map
    Add pwBlend (blend half-width in hall counts) to the piecewise clutch
    mapping. Replaces the sharp breakpoint corners with monotonic,
    C1-continuous quadratic-Bezier corners so the servo no longer jerks at
    the bite-zone transitions. Clamped per breakpoint so the two corners
    can't cross each other or run past hallMin/hallMax. Plumbed through NVS,
    /cmd?action=savePiecewiseZone, /configData, and the calibration page
    (input + bounds validation + read-back verify).
    [HallSensorControl.h, WebInterface.h]
2026-06-17 main_node: WiFi toggle via non-blocking 1s long-press
    Replace edge-triggered ISR (source of intermittent toggling from switch
    bounce/noise) with a polled long-press: read PIN_WIFI_SWITCH once per loop
    pass, time the hold with millis(), toggle once after WIFI_LONGPRESS_MS (1000ms)
    of continuous press. No blocking. Removes wifiSwitchISR, wifiTogglePending,
    lastWifiButtonPress, WIFI_DEBOUNCE_DELAY and the attachInterrupt.
    [T89_gearbox_206.cpp]
2026-06-17 main_node: pull down unused legacy clutch input (GPIO15)
    Clutch position now read via ADS1115; GPIO15 fallback pin is no longer
    wired. Switch pinMode INPUT -> INPUT_PULLDOWN so the floating pin stays
    defined without needing an external ground tie.
    [T89_gearbox_206.cpp]
2026-06-17 main_node: report clutch feedback as raw divided voltage
    Drop the CLUTCH_FB_DIVIDER back-scaling so clutchVoltage reflects the
    actual post-divider voltage at the ADS input instead of a recovered
    source value. The divider exists only to keep the pin under 3.3V, and
    bite-point thresholds are captured live in these same volts, so the
    absolute scale is irrelevant. Fixes readings being ~1.7x too high.
    [T89_gearbox_206.cpp]
2026-06-17 main_node web: live voltage to 3 sig digits, drop stray index_new.html
    Show clutch voltage with toPrecision(3) on the home page status line and
    live bite-point readout. Remove unused index_new.html that was being
    bundled into the filesystem image.
2026-06-17 main_node: flash the other 3 matrix corners blue when WiFi on
    The top-right pixel already shows steady blue as the WiFi/heartbeat
    indicator. Blink the remaining three corners blue in sync (500ms) so WiFi
    status reads from any corner. Drawn only on the "on" phase so the tach
    column and gear digit show through between blinks.
2026-06-17 main_node: dedicated core-0 clutch task + early idle PWM
    Move paddle->servo tracking out of loop() into a high-priority FreeRTOS
    task pinned to core 0, so the clutch follows the paddle at a steady 200Hz
    regardless of loop() load (web server, CAN, matrix). The task only drives
    the servo when idle or in manual mode; during shift sequences the state
    machine in loop() keeps control (task stands off when !isIdle). Split
    ManualMode clutch control (-> task) from button/relay handling (stays in
    loop).
    Also attach the servo and emit idle PWM as the very first action in
    setup(), before Serial/LittleFS/etc. The ASME-MR servo takes ~2s to
    re-acquire its PWM signal after the pulse stream drops on MCU re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
2026-06-17 rear_node: clear UP/DOWN shift box on gear change
    The shift-direction indicator lingered for the full 3s timeout. Clear it
    as soon as the gear settles into a new gear (any direction) so it reflects
    the actual shift; the 3s timeout remains as a backstop for a shift that
    never completes.
2026-06-22 main_node: lower RPM PCNT filter to 800 cycles; swap home servo gauges
    - RPM.h: PCNT glitch filter 1023 -> 800 (~10 µs)
    - index.html: swap Servo Position Commanded / Reported Position order
    [RPM.h]
2026-07-01 sensor_node: pump PWM to PB1 @100Hz + PA1 pot test override
    Move pump PWM output from PB0 (TIM3_CH3) to PB1 (TIM3_CH4) and set the
    carrier to 100 Hz for the real pump's onboard controller. Add a bench
    test override: pot on PA1 sets pump duty 0-100% (bypasses the temp
    schedule and CAN pump cmd), mapped across the full 0-255 range for a
    true 0-100% duty.
    TEST STATE - revert the pot override to temp-based control before deploy.
    [main.cpp]
2026-07-02 sensor_node: 4-zone temp-based cooling pump control
    Replace the pot test override with the real engine-temperature cooling
    algorithm driving the smart pump's speed command (DS18B20 = engine water
    temp). 4-zone piecewise-linear curve, all inside the pump's usable
    15-90% band so it always circulates minimum flow:
    <=65C -> 15% min flow / warm-up (avoids head hot-spot boiling)
    65-80C -> 15..40% transition
    80-85C -> 40..75% target zone (~82C), active modulation
    85-101C -> 75..90% high heat loading
    >=101C -> 90%; DS18B20 fault -> 90% forced
    Boot at 15% min flow (never 0%, which is the controller's failsafe =
    full). Keep percent->0..255 mapping for the 8-bit analogW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
    [PumpControl.h, main.cpp]
2026-07-02 sensor_node: wait for TX FIFO space to stop dropping CAN frames
    The H5 FDCAN TX FIFO is only 3 elements deep. Each 5 Hz cycle the node
    queues 6-9 frames back-to-back (6 sensor-data + 3 status/heartbeat) far
    faster than they drain, so canSend() silently dropped everything past
    the 3rd frame: TPS, both fuel levels, pump status, sensor status, and
    heartbeat never reached the bus (only oil/water/radiator got through).
    canSend() now polls HAL_FDCAN_GetTxFifoFreeLevel and waits for a free
    slot before queuing, bounded by a 5 ms guard so a stuck bus can't hang
    the loop. All frames now transmit.
    [SensorCan.h]
2026-07-03 main_node: strip dead states/events from gearbox FSM + fix robustness holes
    - decouple shift actuation from the shiftLogger null-check
    - error recovery returns to idle state for the actual gear, not IDLE_NEUTRAL
    - clear stacked downshift target on error/clutch-wait timeout aborts
    - remove unreachable states (DOWNSHIFT_CLUTCH_ENGAGED, MANUAL_CLUTCH_CONTROL,
    WAITING_FOR_CLUTCH_NEUTRAL_*, ERROR_SENSOR_DISCONNECTED), unused events,
    dead EVENT_RELAY_FINISHED table rows, condition-fn machinery, g_stateMachine
    - clutch state now polled via setClutchPulled only (no more No-transition spam)
    [GearboxStateMachine.cpp, GearboxStateMachine.h, T89_gearbox_206.cpp]
2026-07-03 sensor_node: cut gear display latency (fast path + ADC deadband)
    Gear repaints immediately on change every loop pass instead of waiting
    out the 200ms refresh tick. Analog rows get a deadband (8 ADC counts /
    0.1C) so ADC jitter no longer repaints ~6 rows per tick, which also
    shrinks the SPI-blocking window.
    [SensorDisplay.h, main.cpp]
2026-07-03 rear_node: enforce shift duration limits + fix ACK, reboot loop, LED churn
    - clamp shift_ms (30-200) and ign_cut_ms (10-100) from CAN so a corrupt
    frame can never latch a relay (limits were documented but not enforced)
    - shift ACK uses the target-gear byte for the expected check; half-shifts
    to N and shifts from BETWEEN/UNKNOWN no longer report false FAILED
    - drop esp_restart() on CAN loss: a quiet bus caused a permanent ~3s
    reboot loop when no peers ACKed; driver-level bus-off recovery remains
    - NeoPixel show() only on flash-state change (was busy-waiting the WS2812
    latch every loop iteration)
    - correct stale pin map in the main.cpp header comment
    - drawStatus: clip flag rows to the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
    [GearShift.h, RearCan.h, RearDisplay.h, main.cpp]
2026-07-05 sensor_node_f103: port sensor node to STM32F103C8T6 Blue Pill
    Parallel, non-destructive port alongside the H562 version (kept intact).
    H562 board rejected for physical form factor: dual inner/outer pin rows
    split signal pairs and no protoboard matches its spacing.
    - SensorCan.h rewritten for bxCAN (PB8/PB9 remap, 500 kbps @ 36 MHz APB1,
    3 TX mailboxes in FIFO order, ESR-based health, manual bus-off recovery)
    - Pins reallocated for LQFP48: ADC PA0-PA4, display DC/RST PB10/PB11,
    OneWire PB0; pump PWM stays PB1 (TIM3_CH4)
    - Display renders x10 fixed-point with integer snprintf; _printf_float
    dropped (flash 80% -> 60%)
    - PC13 heartbeat LED at 1 Hz (Blue Pill LED, active low)
    - ST-Link upl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
    [DallasTemp.h, PumpControl.h, SensorCan.h, SensorDisplay.h, main.cpp]
2026-07-06 sensor_node_f103: scale heartbeat LED blink with pump duty
    TIM2 toggles PC13 in an interrupt so the rate stays steady while the
    loop blocks on SPI repaints or CAN TX waits: 1 Hz at 15% duty up to
    ~9 Hz at 90%.
2026-07-06 can_ids: document GPS position/speed and IMU accel frame payloads
    Matches the frames now sent by the STM32H723 GPS node and logged by
    the display node. Synced identically across all three projects.
2026-07-08 sensor_node_f103: calibrate water NTC, retire H562 sensor node
    Add NtcTemp.h: measured R/T lookup table (20-150 C) with linear
    interpolation, converting the water-temp ADC channel from raw counts
    to real degrees C. Divider is 4.7k pull-up to 3.3V, NTC to GND
    (2-wire sensor, no block-ground return). Wired into both the F103
    main loop and the display's dirty-check epsilon.
    The F103 build is now the sensor node going forward, so the
    superseded STM32H562 port (src/sensor_node/) and its platformio.ini
    env are removed; full history remains in git.
2026-07-08 sensor node: pump duty from NTC water temp, CAN-adjustable target
    - Drive pump duty from the NTC water temp (200 ms cadence) instead of the
    Dallas radiator sensor; Dallas stays for display + CAN only
    - Parameterize the pump curve around an adjustable target temp: breakpoints
    at -17/-2/+3/+19 C offsets, default target 82 C reproduces the original
    65/80/85/101 curve
    - Accept CAN_SENS_CMD_TARGET_TEMP (0x41) from the display, clamped 65-105 C
    - Drop the DS18B20 -127 C fault check (unreachable: NTC clamps to 20-150 C);
    note that an unplugged NTC reads 20 C -> minimum flow
2026-07-10 sensor node: average water NTC over one pump-PWM period
    20 samples spaced across the 10 ms PWM cycle so pump-PWM ripple coupled
    onto the NTC line cancels in the average instead of wiggling the duty.
2026-07-11 remove unused cooling-node CAN definitions
    NODE_COOLING was always (future) and never built as a separate node;
    the sensor node (NODE_SENSOR) already performs the cooling functions
    (pump control, water/radiator temp).
2026-07-11 sensor node: rename water temp to engine temp, add rad-out NTC on PA5
    - can_ids.h: WATER_TEMP -> ENGINE_TEMP (ID 0x02 unchanged), new
    SENS_RAD_OUT_TEMP 0x0A - synced with the other repos
    - second NTC (same divider/table) on PA5 for radiator outlet temp, sampled
    interleaved with the engine NTC in the same PWM-period averaging burst
    - local display: WATER/DALL rows -> ENG/RADO (Dallas still transmits on CAN,
    just no longer shown locally - the 9 rows exactly fill the panel)
    [NtcTemp.h, SensorCan.h, SensorDisplay.h, main.cpp]
2026-07-13 add sensor_node_h523 port (STM32H523CET6, F103 replacement)
    Ports the sensor node from the STM32F103C8T6 (Blue Pill) to the
    STM32H523CET6 (WeAct BlackPill-style board). Build-verified
    (pio run -e sensor_node_h523 succeeds) but not yet bench-tested.
    Required a custom board definition (boards/generic_h523cetx.json) since
    none existed for this chip, plus two workarounds for gaps in the
    Arduino_Core_STM32 variant this maps to: a missing linker script
    (boards/h523cetx_ldscript.ld, copied from the sibling H503CB variant)
    and a framework bug in stm32h5xx_ll_dlyb.c unrelated to anything this
    project uses (disabled via HAL_SD/OSPI/XSPI_MODULE_DISABLED). Full
    details and the pin-map diff from the F10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
    [DallasTemp.h, NtcTemp.h, PumpControl.h, SensorCan.h, SensorDisplay.h, main.cpp]
2026-07-13 sensor_node_h523: bring to parity with engine-temp/rad-out NTC rename
    The h523 port was written just before 8409abe renamed water temp to
    engine temp and added a second (rad-out) NTC on the F103 build,
    breaking the h523 build (CAN_SENS_WATER_TEMP no longer exists). Mirrors
    that change: engine temp stays on PA5 (renamed from "water"), rad-out
    temp lands on PA6 rather than F103's PA5 since PA0's button shift
    already uses PA5 here. Build-verified.
    [NtcTemp.h, SensorCan.h, SensorDisplay.h, main.cpp]
2026-07-17 sensor nodes: add integral trim so engine temp converges on target
    The 4-zone curve alone is proportional-only: below target it commands
    more than minimum flow, so the engine can stall short of target
    (observed: stable 70 C at ~22% duty with an 82 C target). Keep the
    curve as feedforward and add a slow integral bias (0.2 %/degC/s,
    clamped +/-25%) with conditional anti-windup so the bias stays frozen
    while the output sits at the 15% floor or 90% cap. Call sites are
    unchanged; dt comes from millis() inside pumpDutyForTemp().
    Applied identically to the f103 and h523 nodes.
    [PumpControl.h]
2026-07-19 sensor nodes: aux-fan relay control on PB3/PB5; display DC/RST to PA15/PB4
    FanControl.h (both nodes): two staged active-high relay outputs — FAN1
    at target+3 C with the pump pinned at its 90% cap, FAN2 at target+8 C,
    both after a 5 s dwell, with release hysteresis at target / target+4.
    Boot self-test clicks each relay once as a wiring check. Bench-tested
    on the f103 (board is active-high — energizes on high input).
    Display DC/RST move from PB10/PB11 (f103) and PB10/PB2 (h523) to
    PA15/PB4 on both, so all display lines share one board edge and both
    nodes take identical display wiring; frees I2C2/USART3 pins. Verified
    on the f103 display.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
2026-07-22 sensor_node_h523: swap TFT_RST/FAN1 to PB3/PB4
    Groups the two display pins (DC=PA15, RST=PB3) adjacent on the header
    instead of straddling the fan relay pins (previously DC-FAN1-RST-FAN2).
    Not bench-tested - board wiring needs to move to match.
    [FanControl.h, SensorDisplay.h]
2026-07-22 sensor_node_h523: swap CAN and fan-relay pins (PB7/PB8 <-> PA12/PA11)
    FDCAN1 moves to PA12(TX)/PA11(RX), the other valid pin pair for this
    peripheral on this chip, freeing PB7/PB8 for the fan relays (previously
    PB4/PB5, which are now unclaimed). Not bench-tested - board wiring is
    still at the layout stage, hasn't been soldered yet.
    [FanControl.h, SensorCan.h]
2026-07-22 sensor_node_h523: switch upload to pyocd, OpenOCD has no STM32H5 support
    upload_protocol = stlink fails outright on this env: PlatformIO's bundled
    OpenOCD (checked through the latest tool-openocd 3.1200.7) has no
    target/stm32h5x.cfg or stm32h5x flash driver compiled in at all. Switched
    to upload_protocol = custom running `pyocd flash -t stm32h523cetx`, which
    flashes via the STM32H523CETx CMSIS pack instead of OpenOCD target
    scripts. Bench-flashed successfully now that the board has arrived.
2026-07-22 sensor_node_h523: CAN back to PB7/PB8, fan relays to PA11/PA12
    Reverts the previous swap: FDCAN1 returns to PB7(TX)/PB8(RX), matching
    the F103's CAN pin intent. Fan relays move to PA11/PA12 instead — free
    on this node since it has no USB (unlike the H723 transmitter, where
    those pins are USB-C). Flashed and bench-verified.
    [FanControl.h, SensorCan.h]
2026-07-29 sensor_node_h523: self-contained DS18B20 driver, drop OneWire/DallasTemperature
    The node hung during boot whenever the DS18B20 was physically attached. Two
    defects in the library path, both specific to this core:
    OneWire's ARDUINO_ARCH_STM32 backend maps DIRECT_MODE_INPUT/OUTPUT to
    pin_function() -> HAL_GPIO_Init(), and read_bit() calls two of them inside the
    read slot. The DS18B20 holds read data valid for only 15 us after the falling
    edge; the HAL calls plus the library's 3+10 us waits put the sample at ~17 us,
    so zeros read back as ones - but only once a device is on the bus, which is why
    it behaved with the sensor unplugged.
    DallasTemperature::getTempCByIndex() runs a full 64-bit ROM s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
2026-07-29 sensor_node_h523: draw the GEAR value on the first display update
    s_d_gear was seeded with GEAR_UNKNOWN (0xFF), which is also the gear value at
    boot, so the changed-check in displayUpdateGear() never fired and the GEAR row
    stayed blank until the first real gear message arrived. Every other cached
    value is seeded out of range (-99.0f, 0xFF, 0xFFFF) precisely to force that
    first draw; gear was the one that wasn't.
    Seeded with 0xFD instead - not a valid gear code, and distinct from both
    GEAR_UNKNOWN (0xFF) and GEAR_BETWEEN (0xFE).
2026-07-30 sensor_node_h523: debug UART/SPI2 ALT-pin fixes, CAN/ADC hardening
    Bench bring-up (2026-07-25) found this variant's PeripheralPins.c maps
    some pins twice (plain vs _ALT1) to different peripherals, silently
    picking the wrong one with no error until HAL init hangs:
    - Debug prints rerouted to a dedicated DebugSerial on USART1
    (PA9_ALT1/PA10_ALT1); the framework's default Serial sits on UART4
    PA0/PA1, colliding with the onboard button and oil-pressure ADC pin.
    - SensorDisplay.h's SPI2 MOSI moved to PB15_ALT1 - plain PB15 resolves
    to SPI1 on this variant, which hung SPI init with no error.
    Also, while bringing sensors up:
    - CAN bus-off recovery is now a non-blocking poll-driven state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
    [SensorCan.h, SensorDisplay.h, main.cpp]
2026-07-30 sensor_node_h523: DS18B20 reliability, fuel1 2-point calibration
    DS18B20 was intermittently reporting -126 C between good reads:
    - Presence-detect sampled at 70 us, right on the edge of the device's
    15-60 us response window; moved to 75 us for margin.
    - CRC-8 alone lets a corrupted scratchpad through roughly 1 read in 256,
    so a physical range check (-40..130 C) now rejects values that pass CRC
    but can't be real coolant temperatures.
    - A single bad read no longer jumps the display to the -127 "no sensor"
    value: the last good reading is held, and the sensor is only declared
    lost after 5 consecutive failures.
    Fuel1: sender measured 0.4-191.4 ohm, which spans only ~410-1179 AD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
    [DallasTemp.h, main.cpp]
2026-07-31 main_node: 16x16 matrix (4x 8x8 tiled 2x2), drop startup animation
    The gear/tach matrix is now four 8x8 clone panels wired 2x2 on one data
    line. Switched to the tiled Adafruit_NeoMatrix constructor and scaled the
    layout up: tach bar is 2 columns and 16 rows (each existing RPM band now
    lights two rows, thresholds untouched), gear glyph is text size 2, and
    the heartbeat/WiFi/manual-mode indicators are 2px blocks and bars rather
    than single pixels. Pixel loops replaced with fillRect/drawFastHLine.
    NEO_MATRIX_COLUMNS was found empirically. The panels' DI/DO pads sit on
    diagonally opposite corners, which does not distinguish ROWS from COLUMNS
    (both produce a diagonal pad layout) -- ROWS rendered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
    [MatrixDisplay.h]
2026-08-01 sensor_node_h523: move to STM32H523CCT6 (256 KB), original CET6 died
    The CET6 failed on the car (internal VDD-VSS short, classic overvoltage
    signature). Replacement stocked is the CCT6: same die, same LQFP48 pinout,
    same 272 KB RAM, 256 KB flash instead of 512 KB.
    No source, pin map or clock changes were needed. The Arduino core variant
    folder already covers both (H523C(C-E)...), the build is 58,892 bytes =
    22.5% of 256 KB, and nothing stores data in flash. Verified by building
    against both board files and diffing: the two firmware.bin were identical.
    - boards/generic_h523cctx.json: new, maximum_size 262144
    - boards/generic_h523cetx.json: removed
    - h523cetx_ldscript.ld -> h523_ldscript.ld: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
2026-08-07 main_node: custom 2px bitmap font for the gear/status matrix
    setTextSize(2) scaling of Adafruit_GFX's built-in 5x7 font produced
    blocky 2x2-pixel diagonal steps once the matrix grew to 16x16 (four 8x8
    panels tiled 2x2). A native-resolution GFX font (FreeSansBold9pt7b) fixed
    the scaling but its stock glyph shapes still weren't sharp enough at
    this size.
    Replaced both with a hand-built bitmap font (GearFont.h): digits 1-6 are
    drawn as 7-segment shapes with no diagonals at all, so they stay crisp
    regardless of resolution. N's diagonal is stepped once every 3-4 rows
    instead of every row so it reads as a smooth diagonal rather than a
    staircase. D/U/C/F/? are built from straight bars only. W (the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
    [GearFont.h, MatrixDisplay.h]
2026-08-07 main_node: redraw all glyphs in the gear matrix font
    All 13 GearFont.h bitmaps replaced. Widths and the glyph table are
    unchanged (12px, 14px for W), so MatrixDisplay.h needs no edits.
    Data checks pass: every array is 16 rows, and every row value fits
    inside its glyph's declared width. Also restored the trailing newline
    at EOF, dropped by the previous edit.
    Build verified: `pio run -e main_node` succeeds, no warnings from this
    header. RAM 14.5% (47392/327680), flash 17.5% (1144095/6553600). The
    only warnings in the build are the pre-existing legacy-pcnt driver
    deprecation from RPM.h.
    Getting there needed a local toolchain fix, unrelated to this repo:
    ~/.platformio/packages held the xtensa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
    [GearFont.h]
2026-08-08 main_node: 16-row tach resolution, triangular WiFi corner flags
    updateTachometer() previously computed 8 RPM bands (from before the
    matrix went 16 rows tall) and doubled each into two rows. Now there are
    16 real per-row bands: every original tuned threshold (3000/5000/7500/
    9000/10500/12000/13500) is preserved exactly, with one extra step
    inserted in each original gap (two in the top gap, to land on 15
    thresholds for 16 bands), so the green/yellow/orange/red proportions are
    unchanged, just twice as granular. Also fixed a stale comment on the
    9000rpm band -- it said "Yellow" but the color coded was, and stays,
    green.
    The three flashing WiFi-status corners (top-left, bottom-left,
    bottom-right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
    [MatrixDisplay.h]
2026-08-13 Add main_node_integratedweb: embedded web pages via board_build.embed_txtfiles
    - Create new src/main_node_integratedweb/data/ with copies of index.html, nvsconfig.html, calibration.html
    - Add [env:main_node_integratedweb] to platformio.ini using PlatformIO's embed_txtfiles
    - Pages remain as normal HTML files (editable), auto-embedded at build time
    - No LittleFS dependency, no filesystem mounting required
    - Ready for WebInterface.h integration
2026-08-13 WebInterface: add embedded file serving support (WEBINTERFACE_USE_EMBEDDED)
    - Add embedded file symbol declarations for index.html, calibration.html, nvsconfig.html
    - serveEmbeddedFile(): stream binary data directly without LittleFS
    - servePage(): unified handler that selects embedded or LittleFS based on flag
    - Update handleRoot, handleHelloPage, handleCalibrationPage, handleNvsConfigPage
    - All handlers now work with both LittleFS and embedded builds
    - To use: build env:main_node_integratedweb (embeds files)
    - Or build env:main_node (uses LittleFS as before)
2026-08-13 Add new piecewise mapping page with visual hall/servo zone editor
    - New piecewise.html: dedicated UI for biting zone calibration
    - Hall bar with dual sliders A/B (zone start/end), idle/max buttons
    - Servo bar with dual sliders A/B mapped to hall's A/B (cannot cross)
    - Live puck indicators show current values
    - Corner smoothing blender (0-2000 ADC counts)
    - Servo control toggle: manual slider for testing (disables paddle control)
    - Save button only enabled when values change
    - A cannot cross B constraint enforced on both hall and servo sliders
    - WebInterface.h: add piecewise route, embedded file symbols, handler
    - Works with both LittleFS (main_node) and embedded (main_node_integratedweb)
    Co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
2026-08-13 Position max buttons on right side of bars
2026-08-13 Move A/B labels above bars, max button to right
2026-08-13 Fix embedded web serving; rework piecewise bar layout
    main_node_integratedweb never actually served its embedded pages. Three
    separate faults, each hiding the next:
    - platformio.ini declared embed_txtfiles but never defined
    WEBINTERFACE_USE_EMBEDDED, so the build compiled the LittleFS path and
    had no filesystem to read from.
    - The extern declarations omitted the path prefix objcopy derives symbol
    names from (_binary_src_main_node_integratedweb_data_*_html_start).
    - serveEmbeddedFile() set Content-Length via sendHeader(), which appends
    rather than replaces; _prepareHeader() then appended its own, so every
    page went out with two conflicting Content-Length values and browsers
    refus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
    [WebInterface.h]
2026-08-13 Restore gutted embedded calibration page; piecewise zone/extent rework
    The embedded copy of calibration.html had been split to load a
    /calibration.js that was never created, never routed and never listed in
    embed_txtfiles. It had lost ~760 lines of JavaScript — live data polling,
    gauge drawing, the calibration wizards, servo override, relay and timing
    tests — so main_node_integratedweb served a dead page while the LittleFS
    build served a working one. Restored from src/main_node/data/ and both
    data directories are now byte-identical across all four pages.
    Nav: Piecewise moved last, so every page reads Home, Calibration, NVS
    Config, Piecewise.
    piecewise.html:
    - Idle/Max are now travel ex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
2026-08-13 Embed pages from src/main_node/data; drop duplicate page directory
    main_node_integratedweb now embeds src/main_node/data/ directly instead of
    a second, byte-identical copy under src/main_node_integratedweb/data/.
    That duplicate existed only to be compiled in, had to be hand-synced after
    every edit, and had already drifted badly enough to ship a dead
    calibration page (see e331cb4). Both envs now use one directory, so they
    cannot diverge again.
    objcopy derives symbol names from the embedded file's path, so the externs
    in WebInterface.h move with it:
    _binary_src_main_node_integratedweb_data_* -> _binary_src_main_node_data_*.
    Verified against nm on the generated .txt.o files after a clean build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
    [WebInterface.h]
2026-08-13 Unify page chrome: shared tab bar and title across all four pages
    The four pages had drifted into four different headers: index put the
    title above the nav, nvsconfig put the nav above the title, piecewise had
    its own .nav-btn styling, and calibration buried the title inside
    .wizard-header. Each also styled h1 differently.
    All four now share one block: tab bar, colour rail, .page-title,
    .page-sub. The nav is a tab strip -- every tab has square bottom corners
    and the active one spreads to fill the row and runs into a full-width rail
    in its own colour, so the active tab and the page below read as one shape.
    calibration's .wizard-header keeps only the progress bar; its title and
    description m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
2026-08-13 Unify page containers so the tab bar matches across pages
    The container was 1200px on a #333 rounded panel for index and
    calibration, but 620px and 900px on bare background for nvsconfig and
    piecewise. Body spacing differed too: margin:20px on two pages,
    margin:0/padding:20px on the other two. Since the tab bar is now the top
    element on every page and inherits the container width, the strip visibly
    changed width and backdrop when navigating between pages.
    All four now use margin:0/padding:20px on body and a plain 1200px
    container with no panel. nvsconfig is a settings form, so its cards and
    actions keep a 620px cap for readability while its container stays full
    width, which keeps the tab ba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
2026-08-14 Gate the downshift on real servo feedback; abort if unconfirmed
    The home page's "Auto-Downshift Trigger" widget wrote clutchJustEngagedV,
    but the downshift gate compares against clutchDisengageV. Nothing in the
    shift path ever read the value the widget set, so the control did nothing:
    setting it stored a number that was saved to flash, published in JSON, and
    otherwise ignored. clutchJustEngagedV feeds only the clutchJustEngaged
    flag, which no logic reads at all. Widget now calls setDisengageV, and its
    display and load path read clutchDisengageV to match.
    Downshift sequence is now: request -> servo pulls -> wait for the feedback
    voltage to fall past the trigger -> only then send the DS CAN c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
2026-08-14 One writer per clutch value; enforce real servo travel
    Audit of the clutch paddle/servo path found two values writable from two
    pages each, with no cross-refresh between them, so a stale open page
    silently reverted the other.
    Piecewise zone (hall A/B, servo A/B, corner smoothing) was writable from
    both calibration.html and piecewise.html, both POSTing savePiecewiseZone.
    piecewise.html is now the only writer; calibration.html shows the same
    values read-only and links there. Its "Use Piecewise Mapping" button stays
    — that selects the curve type, a separate concern with no other home.
    Downshift trigger voltage was writable from index.html (typed, via
    setDisengageV) and calibration.html (liv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
    [CalConfig.h, GearboxStateMachine.h, HallSensorControl.h, T89_gearbox_206.cpp]
2026-08-14 Stacked downshifts release only to the bite point
    Between stacked downshifts the clutch was returning fully to idle: the
    stacked path only fires the next shift once isIdleState() is true, and
    entering an idle state calls releaseClutch(). Every consecutive downshift
    therefore paid a full round trip through the dead travel.
    New DOWNSHIFT_PARTIAL_RELEASE state. When the relay pulse ends with a
    stack still pending, the machine holds there instead of going idle, walks
    the servo command back toward idle, and stops as soon as feedback reaches
    clutchJustEngagedV. The next shift then pulls from the bite point rather
    than from idle.
    The release is stepped rather than commanded outright because the b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
2026-08-14 Standardise clutch terminology; fix two backwards-named functions
    released / engaged / disengaged / pulled were used interchangeably and
    often contradicted each other, so one vocabulary now applies everywhere:
    paddle idle + high feedback V = clutch ENGAGED (driving)
    paddle max + low feedback V = clutch DISENGAGED
    Two functions were named the exact opposite of what they did:
    engageClutch() wrote clutchFullyPull -> DISENGAGES -> clutchToMax()
    releaseClutch() wrote clutchIdlePos -> ENGAGES -> clutchToIdle()
    Renamed by the position they command rather than the clutch state they
    produce, which is unambiguous at the call site and matches the Idle/Max
    labels the bars already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
    [CalConfig.h, GearboxStateMachine.cpp, GearboxStateMachine.h, HallSensorControl.h, T89_gearbox_206.cpp, WebInterface.h]
2026-08-14 Drop "release" from clutch naming — it means both states at once
    Follow-on to 12f82f5. "Release" is not merely loose, it is contradictory:
    pulling the lever RELEASES the clutch mechanism, while releasing the lever
    ENGAGES it. The same word names opposite states depending on whether the
    control or the mechanism is meant.
    The stacked-downshift work added in 54aafdb used it throughout, in the
    lever sense (moving back toward idle) — which reads as the opposite under
    the mechanism sense. Renamed to bite-point language, which has no such
    double meaning:
    DOWNSHIFT_PARTIAL_RELEASE -> DOWNSHIFT_TO_BITE_POINT
    enterPartialReleaseState -> enterBitePointState
    updatePartialRelease -> upd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
    [GearboxStateMachine.cpp, GearboxStateMachine.h, HallSensorControl.h, T89_gearbox_206.cpp]
2026-08-14 Move clutch voltage thresholds to Calibration, beside the servo slider
    Capturing either threshold means driving the clutch to a position, and the
    manual servo slider is on Calibration — so having the thresholds on Home
    split the job across two pages. Calibration also already draws both as
    markers on a live voltage bar directly beneath that slider, so the
    feedback needed to judge the capture was there and the controls were not.
    Both now live on Calibration with a typed box and a Capture Live button
    each, still exactly one writer per value. Home keeps a read-only summary
    of the two values and links across.
    CLAUDE.md page roles updated to match, and now records the two rules this
    kept tripp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
2026-08-14 CLAUDE.md: correct piecewise owner, servo bounds, threshold home
    Three sections still described the pre-consolidation state: the piecewise
    zone as calibration.html-only (moved to piecewise.html in 9361b70), servo
    angles as 0-180 (tightened to the measured 42-137 travel in the same
    commit), and no mention of where the two clutch voltage thresholds live
    after ce13441.
2026-08-14 Reverse the clutch voltage bars so idle is on the left
    Both live voltage displays on the calibration page ran 0 V left to 3.3 V
    right, which put fully disengaged on the left and idle on the right — the
    opposite of every bar on the piecewise page, where idle is left and max is
    right. Reading one page after the other meant mentally flipping.
    Both now run idle (3.3 V) on the left to fully disengaged (0 V) on the
    right, via a vPos() helper: a value's distance from the left edge is how
    far it has travelled from idle, not its raw magnitude.
    This also fixes the marker order. On the old axis the disengage marker sat
    to the LEFT of the just-engaged marker, while the legend beneath listed
    just-eng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
2026-08-14 Swap threshold boxes so each sits under its own marker
    With the voltage bar reversed in a538f91, just-engaged sits at ~73% and
    the downshift trigger at ~84% — but the setting boxes below still had the
    trigger on the left and just-engaged on the right, so each box was under
    the other one's marker.
    Pure reorder of the two sibling divs in the threshold grid. Every id,
    function name, colour, label and input range is untouched; verified the
    swapped block is a character-for-character permutation of the original.
2026-08-14 Servo travel limits are settable, not compile-time
    My earlier change made calValidate() reject any servo angle outside
    CLUTCH_SERVO_MIN/MAX (42-137), on the assumption those were immutable
    measured facts. They are not: the clutch wears, the real stop moves, and
    re-finding it means deliberately widening the limits, then easing the
    manual slider out while watching the arm until it stops. A compile-time
    bound made that procedure impossible — the values exist precisely to be
    changed.
    clutchIdlePos / clutchFullyPull now ARE the travel limits rather than
    operating points inside a fixed range. applyServoLimits() feeds them to
    SimpleServo::setLimits(), called from saveConfig() (which every path t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
    [CalConfig.h, GearboxStateMachine.h, HallSensorControl.h, T89_gearbox_206.cpp, WebInterface.h]
2026-08-14 Diagnose and unblock NVS exhaustion: shift logs were filling the partition
    "nvs write failed" was never field-specific — calNvsWrite stores the whole
    struct in one putBytes, so it cannot fail for max angle and succeed for
    idle. The cause is partition exhaustion, and the numbers only look
    comfortable until you divide them:
    504 used / 630 total = 80%, which reads fine
    but 630 = 5 pages x 126 entries, and 504 = exactly 4 full pages
    so the 126 "free" are precisely the one page NVS reserves for GC
    With 630 - 504 - 126 = 0 erased entries there is nothing to reclaim, so
    the first save consumed the last usable space and every later one failed.
    The space is going to telemetry, not config.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
    [WebInterface.h]
2026-08-14 Move shift logging off NVS onto a LittleFS ring
    Logging never belonged in NVS. It stored 100 discrete blob keys in a
    "shiftlogs" namespace, and wrote three statistics keys on top of that on
    every single gear change — all competing with the calibration blob for one
    630-entry table in a 20 KB partition. Enough shifts and config saves began
    failing with "nvs write failed" and nothing to garbage-collect.
    The spiffs partition is 3.4 MB, 173x the NVS partition, and LittleFS was
    already mounted at boot even in the embedded build, so the storage was
    sitting there unused.
    Shift logs now live in a fixed-size ring file, /shiftlog.bin: a header plus
    5000 slots, oldest overwritten. 50x the history, a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
    [ShiftLogger.h]
2026-08-14 Fix unterminated string that broke the whole NVS Config script
    The confirm() prompt added in 04bf31b contained a literal line break
    instead of an escape, so the string was unterminated. That is a parse
    error, and a parse error takes out the entire script — DOMContentLoaded
    never fired, so every field on the page stayed empty. Other pages were
    unaffected because each has its own script.
    Cause was my generator: the escape was written as a real newline in the
    Python source, so it landed in the file as one. Rewritten without an
    escape at all rather than re-escaping it.
    Checked the other three pages for the same fault by scanning script
    blocks for lines with unbalanced quotes — none.
    Co-Au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
2026-08-14 Label the coolant temp "Engine Out", not "Radiator"
    The Dallas sensor feeding this sits directly after the engine, so the home
    page was calling it the wrong thing in both places: the gauge label said
    "Radiator °C / Pump %" and the readout said "Current".
    UI only. The firmware still calls it radiator throughout — _radiatorTemp
    and getRadiatorTemp() in MainCan.h, getRadiatorTempForWeb() in
    WebInterface.h, and the CAN id CAN_SENS_RADIATOR_TEMP. That id is a
    contract with the sensor node, so renaming it means changing both
    firmwares together; left alone and noted in a comment at the gauge.
2026-08-14 Home gauge reads the sensor the pump is actually controlled from
    Asked whether the temperature really was the engine-out sensor, and
    tracing it showed the gauge and its pump ring were driven by different
    sensors. The sensor node has three: two NTCs (PA4 engine water, PA5
    radiator outlet) and a DS18B20. Pump duty and fan staging both run off the
    PA4 NTC, but the main node was subscribing to CAN_SENS_RADIATOR_TEMP,
    which carries the Dallas. So the outer arc showed one sensor while the
    inner ring reacted to another — the temperature could climb with no
    visible pump response.
    Main node now subscribes to CAN_SENS_ENGINE_TEMP, so both halves of the
    gauge belong to the same control loop. Both se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
2026-08-16 main_node v214: ADS1115 read off loop(), checked I2C with bus recovery
    Track symptom: at high revs the paddles went unresponsive to gear change
    commands, far worse than before the ADS1115 went in, while the clutch kept
    working normally.
    The clutch feedback read ran in loop() as two blocking Wire transactions per
    pass. Wire's default timeout is 50ms per transaction, so an EMI-disturbed bus
    could stall core 1 for up to 100ms per pass. The shift paddles are polled
    edge-detects in processInputs(), so a press+release inside that stall is not
    delayed, it is never seen. The clutch paddle path runs on core 0 at 200Hz,
    which is why it kept working while gear commands died -- and why analogRead,
    whic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
    [MainCan.h, T89_gearbox_206.cpp, WebInterface.h]
2026-08-16 Shift letter dies with the shift, not on a timer
    The matrix letter states intent -- 'N' means "going for neutral", not "in
    neutral" -- but it ran a fixed 300ms regardless of what the box actually did.
    Seen on track: white N sat there after neutral was already engaged, and sat
    there just the same when a short pulse out of 1st overshot into 2nd. Either
    way the display was reporting a gear the box was not in.
    It now ends the moment the rear node confirms a valid gear different from the
    one the shift set off from -- worked or overshot, the intent is settled and
    the letter is stale. Only a valid gear cancels; mid-shift the rear node
    reports GEAR_BETWEEN/UNKNOWN, and cancelling on that would swap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
    [MatrixDisplay.h]
2026-08-16 Add tools/webpreview.py: local preview server for the main_node web pages
    main_node_integratedweb embeds src/main_node/data/*.html into the firmware via
    board_build.embed_txtfiles, so previewing a cosmetic change to those pages meant a
    full compile and flash. The LittleFS env only trades that for an uploadfs step.
    Serving the directory with an ordinary static file server does not work either: the
    nav links are extensionless routes ("/calibration", not "/calibration.html"), so
    every one of them 404s. VS Code Live Preview additionally rejects them with
    "Forbidden. File does not reside within a trusted folder."
    This mirrors the page routes from WebInterface::setupRoutes() and answers the API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
